emoestudio/EmoeKiLib/README.md

# Emoe KiCad Library

本仓库存储了Emoe R&D的KiCad元件库

# Configure

首先，把这个repo clone到你的电脑上，存放在一个安全的路径\:)  
然后在KiCad的 **设置-配置路径** 中添加以下4条(或者更多)  

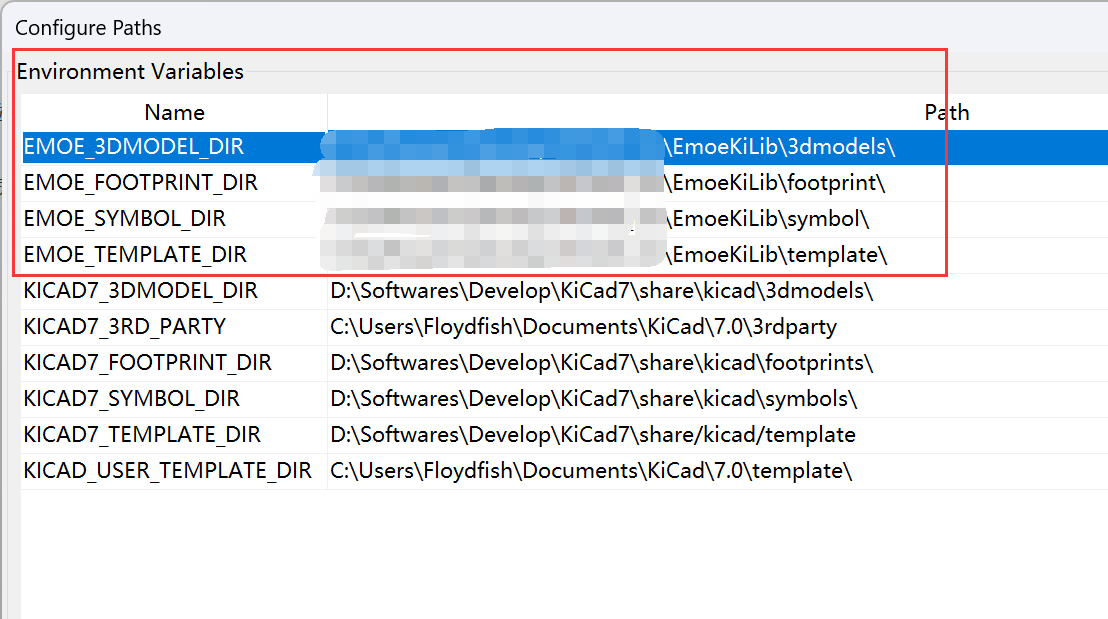
[picture p1: readme_resource/1.png]


这些相当于系统环境变量，他们的作用是在迁移库时使用相对路径，不会发生路径错误问题。  
此时再手动导入你所需要的库，即可使用本库
