emoestudio/EmoeKiLib/3dmodels/Buttons/6.5x6.5x2.55mm_SMD.stp

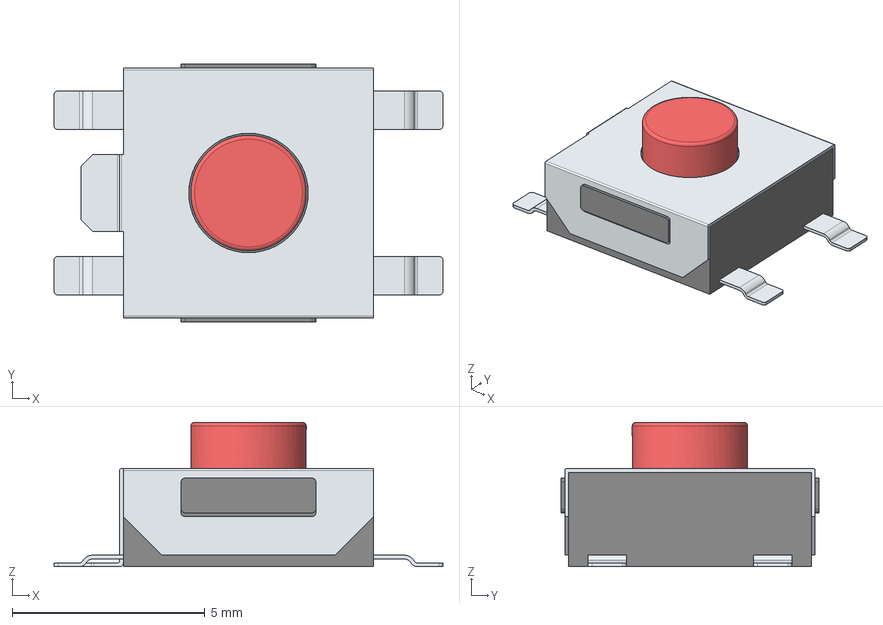
[picture p2: CAD file, 2024-07-07]
3dmodels/Buttons/6.5x6.5x2.55mm_SMD.stp
10.1 x 6.70 x 3.75 mm
Parte_metal
Parte_buton
Parte_mecanism
Parte_pin x 4
