emoestudio/EmoeKiLib/3dmodels/Capacitors/NFM21PC225B0J3D.step

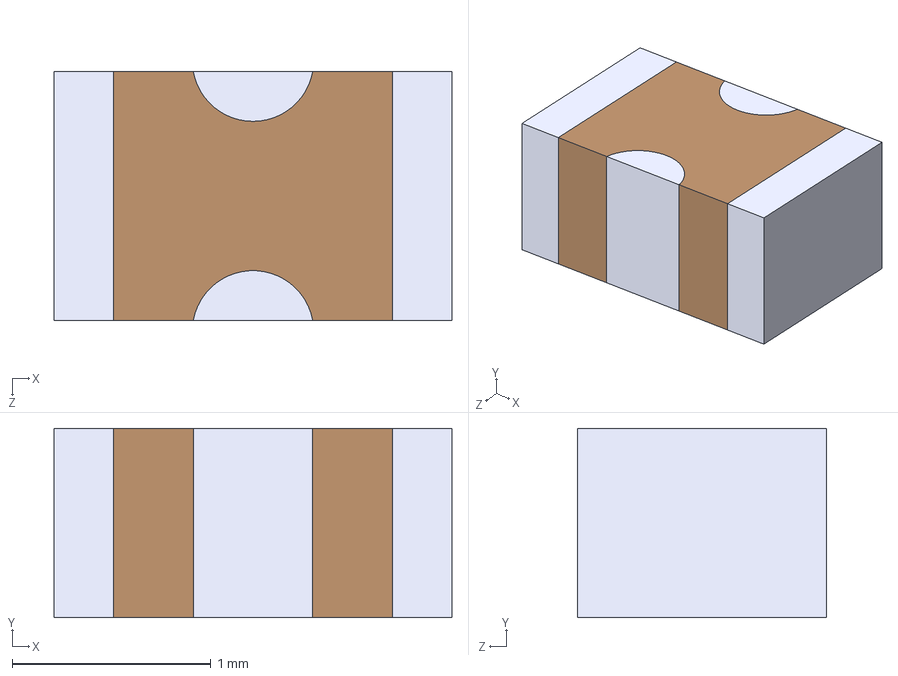
[picture p3: CAD file, 2023-12-09]
3dmodels/Capacitors/NFM21PC225B0J3D.step
2.00 x 0.95 x 1.25 mm
