emoestudio/EmoeKiLib/3dmodels/Connectors/JST_VH3.96/JST - VH - Thru (V) - 4Pin - 3.96mm.stp

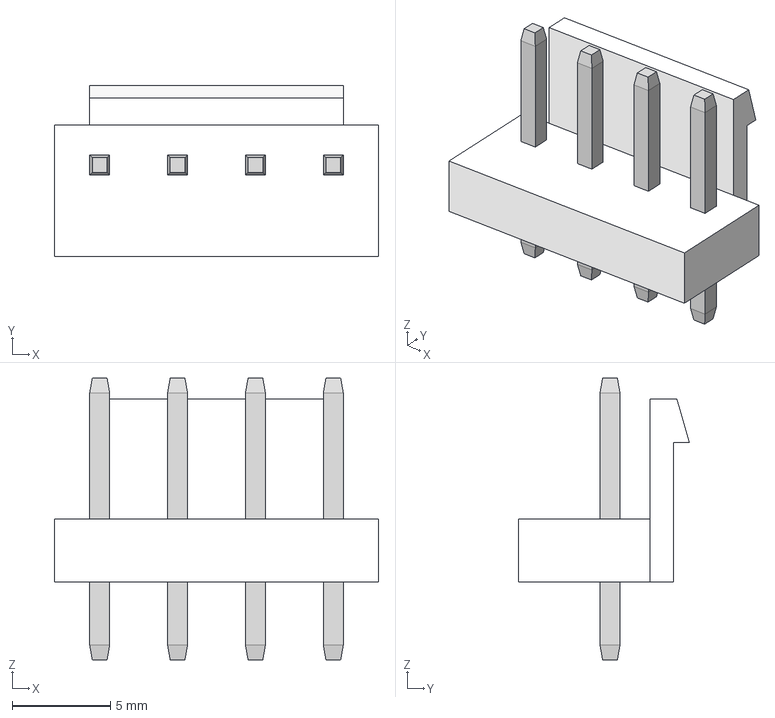
[picture p4: CAD file, 2026-07-21]
3dmodels/Connectors/JST_VH3.96/JST - VH - Thru (V) - 4Pin - 3.96mm.stp
16.5 x 8.69 x 14.3 mm
