emoestudio/EmoeKiLib/3dmodels/Connectors/USB-A-SMD_AF-10.0-QT-ZB6.step

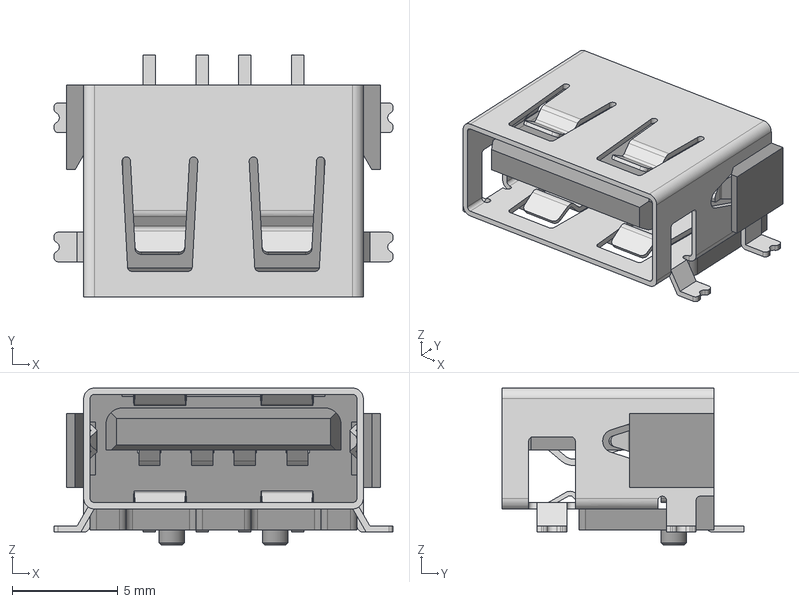
[picture p5: CAD file, 2026-07-21]
3dmodels/Connectors/USB-A-SMD_AF-10.0-QT-ZB6.step
16.0 x 11.4 x 7.40 mm
USB-A-SMD_AF-10.0-QT-ZB6.8~USB-A-SMD_AF-10.0-QT-ZB6.8~VmLX
USB-A-SMD_AF-10.0-QT-ZB6.8~USB-A-SMD_AF-10.0-QT-ZB6.8~VmLX001
USB-A-SMD_AF-10.0-QT-ZB6.8~USB-A-SMD_AF-10.0-QT-ZB6.8~VmLX002
USB-A-SMD_AF-10.0-QT-ZB6.8~USB-A-SMD_AF-10.0-QT-ZB6.8~VmLX003
USB-A-SMD_AF-10.0-QT-ZB6.8~USB-A-SMD_AF-10.0-QT-ZB6.8~VmLX004
USB-A-SMD_AF-10.0-QT-ZB6.8~USB-A-SMD_AF-10.0-QT-ZB6.8~VmLX005
USB-A-SMD_AF-10.0-QT-ZB6.8~USB-A-SMD_AF-10.0-QT-ZB6.8~VmLX006
USB-A-SMD_AF-10.0-QT-ZB6.8~USB-A-SMD_AF-10.0-QT-ZB6.8~VmLX007
USB-A-SMD_AF-10.0-QT-ZB6.8~USB-A-SMD_AF-10.0-QT-ZB6.8~VmLX008
