emoestudio/EmoeKiLib/3dmodels/Crystals/3225_4P_Crystal.STEP

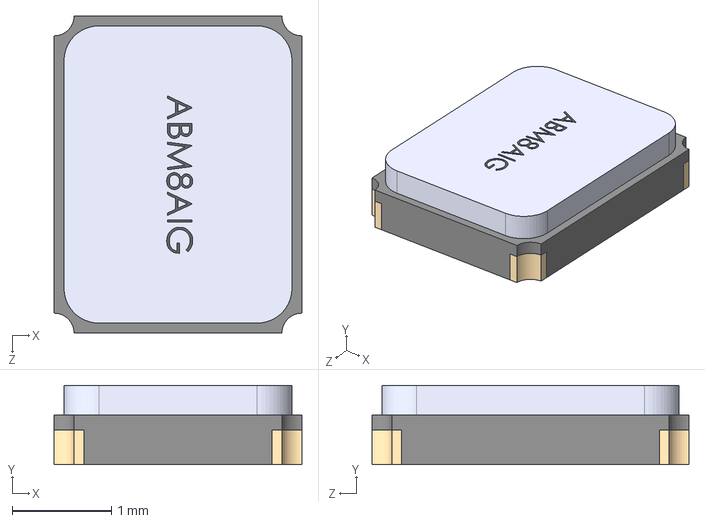
[picture p6: CAD file, 2024-12-31]
3dmodels/Crystals/3225_4P_Crystal.STEP
2.50 x 0.801 x 3.20 mm
