emoestudio/EmoeKiLib/3dmodels/Diodes/TEMD5080X01.stp

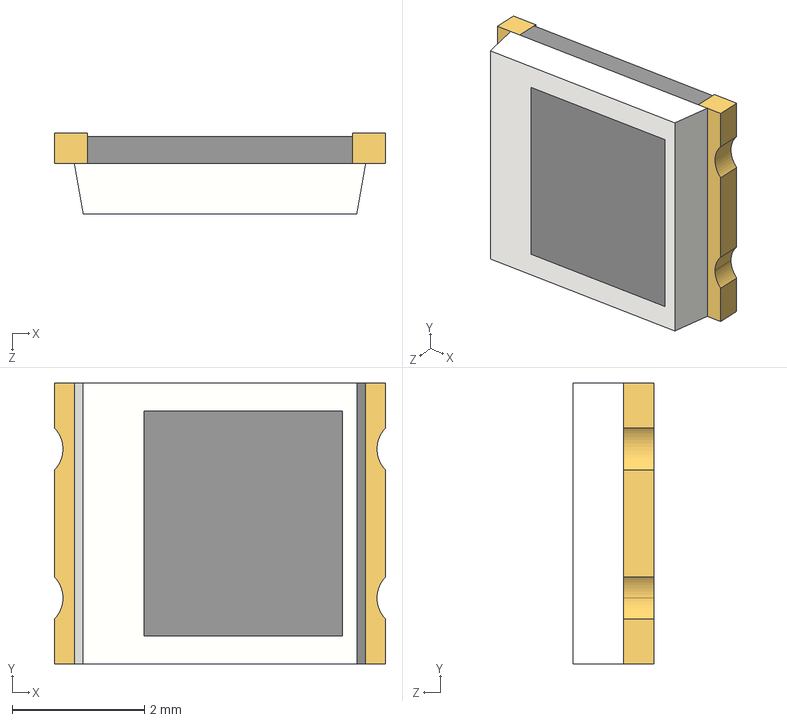
[picture p7: CAD file, 2025-06-23]
3dmodels/Diodes/TEMD5080X01.stp
5.00 x 4.24 x 1.22 mm
