emoestudio/EmoeKiLib/3dmodels/Displays/3mm双孔灯座_上翠绿下红.step

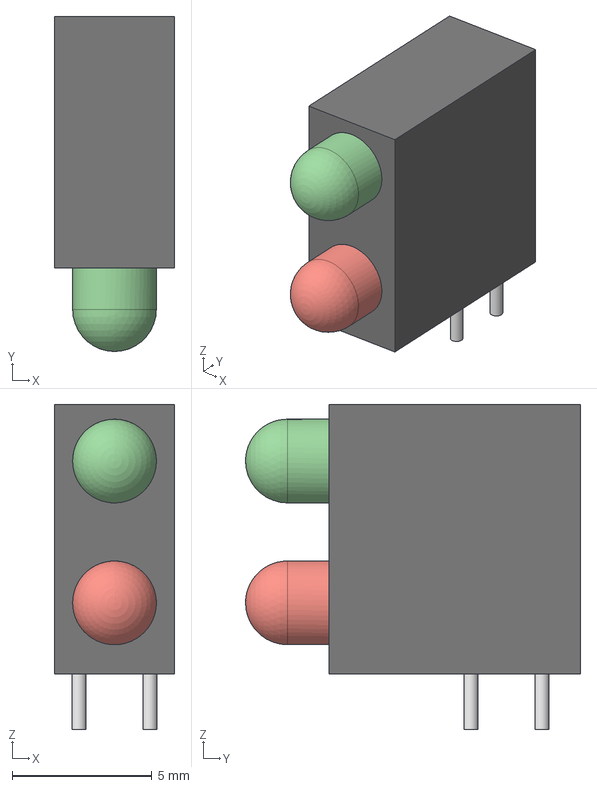
[picture p8: CAD file, 2025-05-03]
3dmodels/Displays/3mm双孔灯座_上翠绿下红.step
4.30 x 12.0 x 11.7 mm
塑料壳
零部件2
零部件3
零部件4
零部件5
零部件6
零部件7
