emoestudio/EmoeKiLib/3dmodels/Inductors/1206_Common_Mode_Choke.STEP

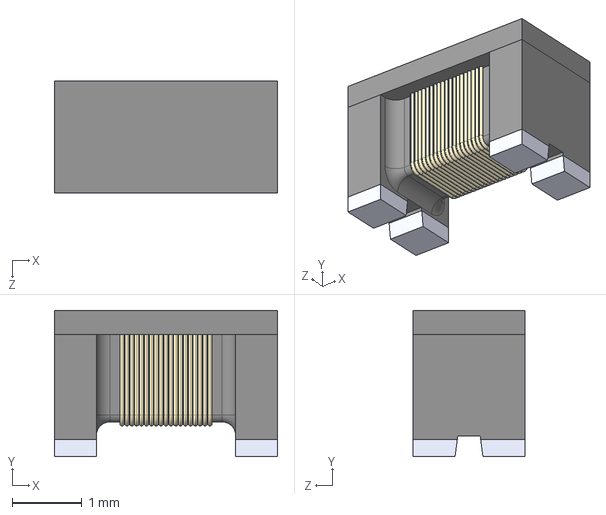
[picture p9: CAD file, 2024-12-31]
3dmodels/Inductors/1206_Common_Mode_Choke.STEP
3.20 x 2.10 x 1.60 mm
