emoestudio/EmoeKiLib/3dmodels/Mechanical/590--3DModel-STEP-630548.STEP

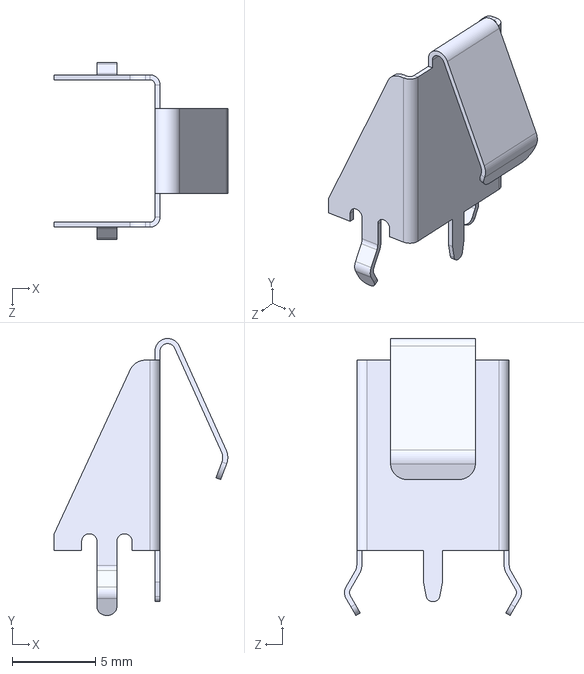
[picture p10: CAD file, 2026-07-21]
3dmodels/Mechanical/590--3DModel-STEP-630548.STEP
10.4 x 16.6 x 10.6 mm
