emoestudio/EmoeKiLib/3dmodels/Package_BGA/LTM8054EY#PBF.stp

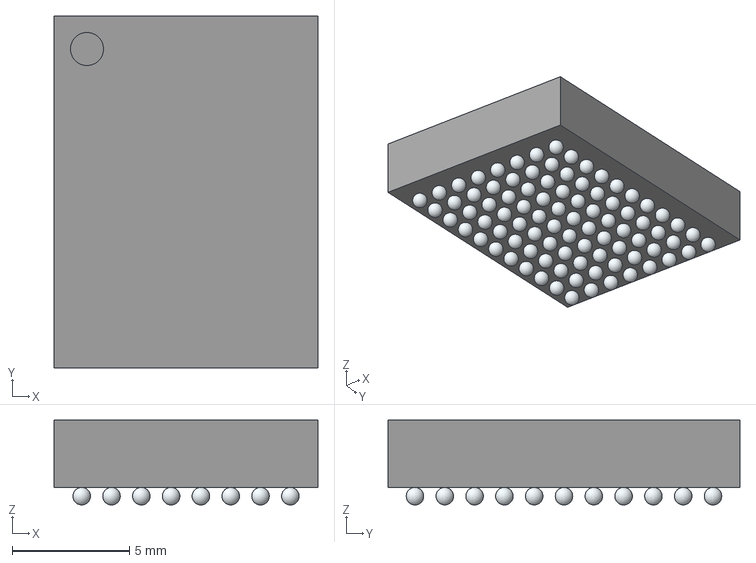
[picture p11: CAD file, 2023-12-09]
3dmodels/Package_BGA/LTM8054EY#PBF.stp
11.2 x 15.0 x 3.62 mm
