emoestudio/EmoeKiLib/3dmodels/Package_LCC/ADR1399KEZ.stp

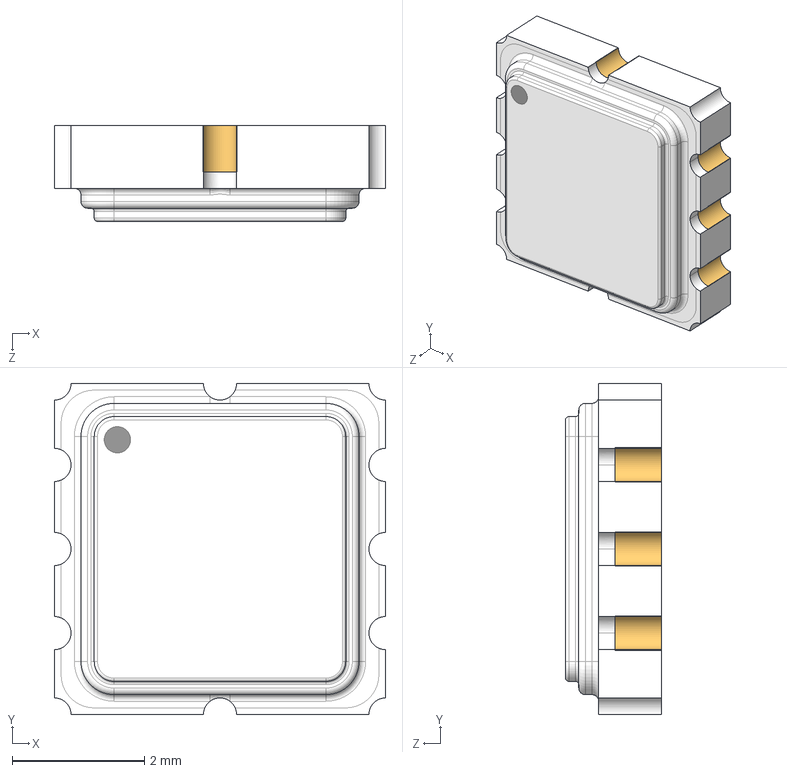
[picture p12: CAD file, 2025-05-23]
3dmodels/Package_LCC/ADR1399KEZ.stp
5.00 x 5.00 x 1.45 mm
