emoestudio/EmoeKiLib/3dmodels/Package_SON/VSON-14-DSJ0014A.stp

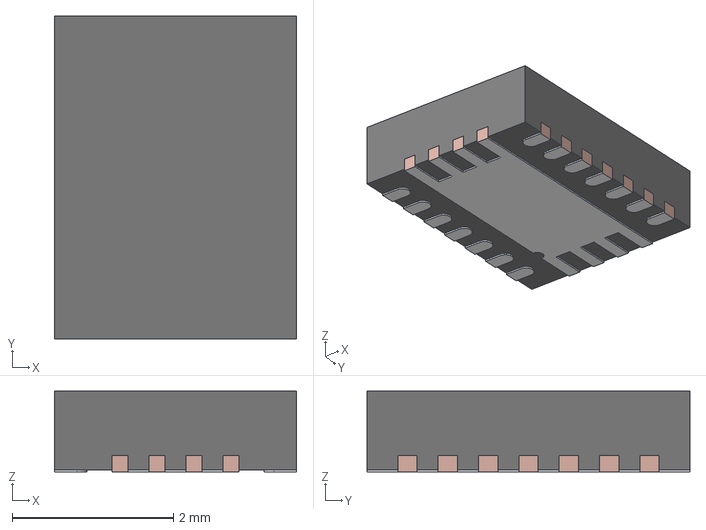
[picture p13: CAD file, 2024-07-07]
3dmodels/Package_SON/VSON-14-DSJ0014A.stp
3.00 x 4.00 x 1.00 mm
FRAME
MOLD
