emoestudio/EmoeKiLib/3dmodels/Package_TO/PA88.stp

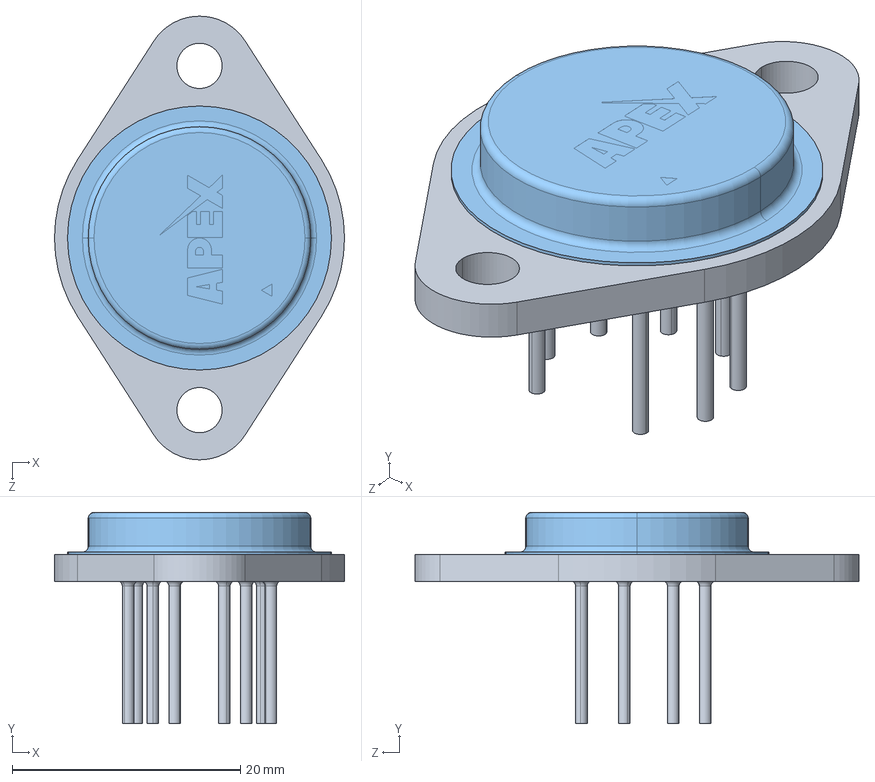
[picture p14: CAD file, 2026-07-21]
3dmodels/Package_TO/PA88.stp
25.4 x 18.5 x 38.9 mm
PHM06M
PSB01
PCM07
