emoestudio/EmoeKiLib/3dmodels/Resistors/VHP203-MetalFoil.step

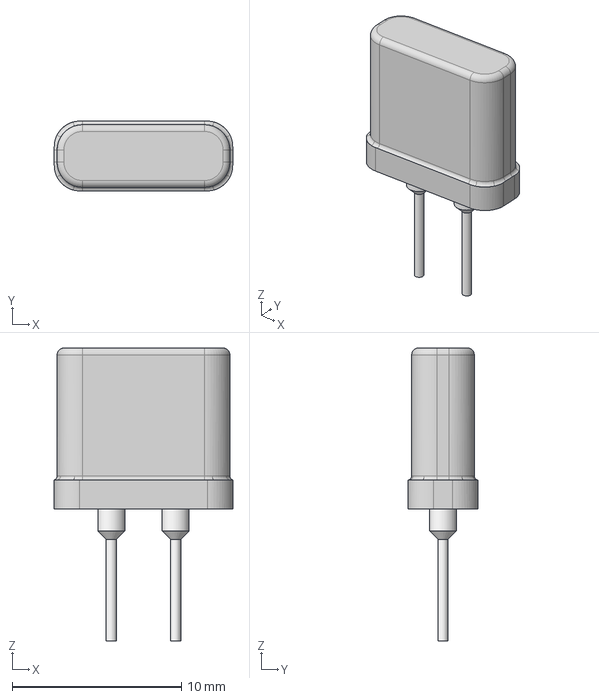
[picture p15: CAD file, 2025-03-30]
3dmodels/Resistors/VHP203-MetalFoil.step
10.5 x 4.12 x 17.3 mm
