emoestudio/EmoeKiLib/3dmodels/Switch_Encoders/SA-0-102-C04.step

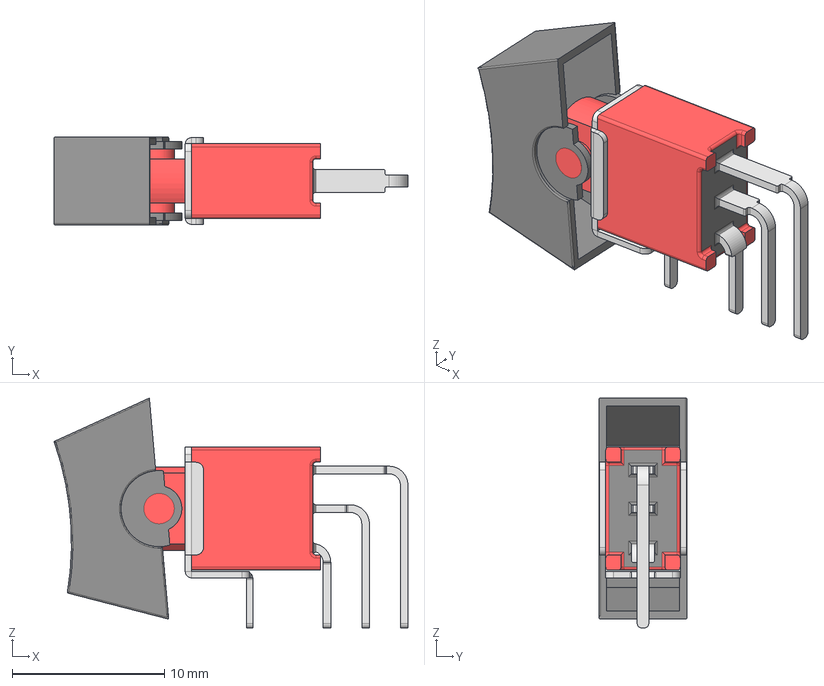
[picture p16: CAD file, 2026-07-21]
3dmodels/Switch_Encoders/SA-0-102-C04.step
23.3 x 5.80 x 15.1 mm
