emoestudio/EmoeKiLib/3dmodels/Connectors/FPC-SMD_20P-P0.50_XUNPU_FPC-05F-20PH20.step

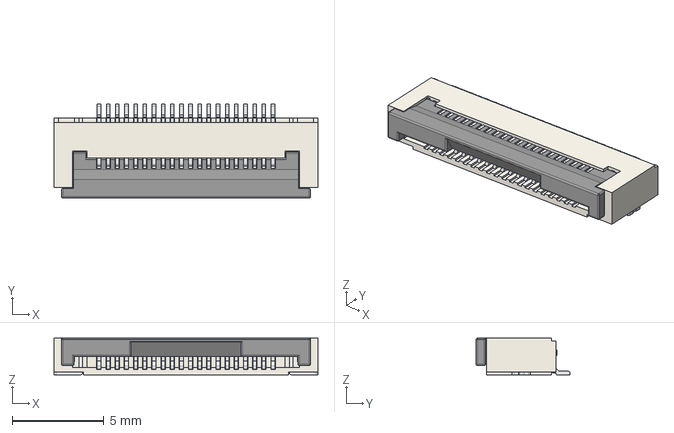
[picture p17: CAD file, 2026-07-21]
3dmodels/Connectors/FPC-SMD_20P-P0.50_XUNPU_FPC-05F-20PH20.step
14.4 x 5.12 x 2.00 mm
