emoestudio/EmoeKiLib/3dmodels/Connectors/JST_VH3.96/JST - VH - Thru (V) - 10Pin - 3.96mm.stp

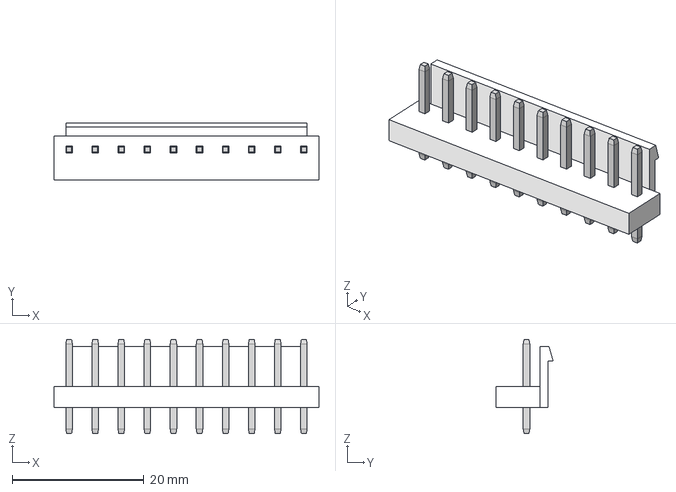
[picture p18: CAD file, 2026-07-21]
3dmodels/Connectors/JST_VH3.96/JST - VH - Thru (V) - 10Pin - 3.96mm.stp
40.2 x 8.69 x 14.3 mm
