emoestudio/EmoeKiLib/3dmodels/Diodes/UMSB30M.stp

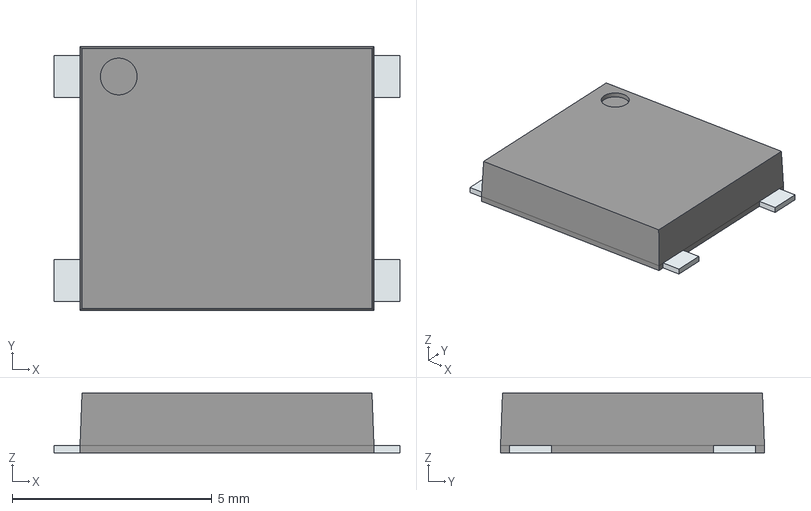
[picture p19: CAD file, 2024-01-21]
3dmodels/Diodes/UMSB30M.stp
8.65 x 6.60 x 1.50 mm
PinsArrayL
PinsArrayR
