emoestudio/EmoeKiLib/3dmodels/Displays/OLED  0.96 inch 64x128.STEP

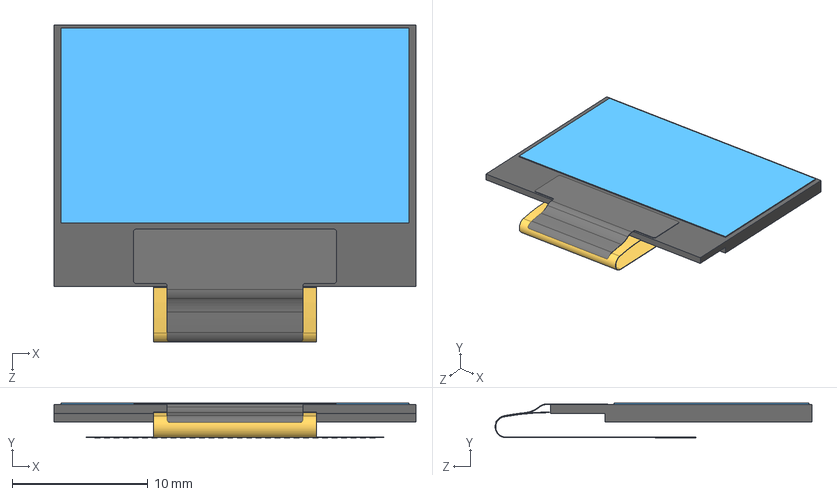
[picture p20: CAD file, 2024-07-07]
3dmodels/Displays/OLED 0.96 inch 64x128.STEP
26.7 x 2.56 x 23.4 mm
