emoestudio/EmoeKiLib/3dmodels/Mechanical/LEP3-4.1.step

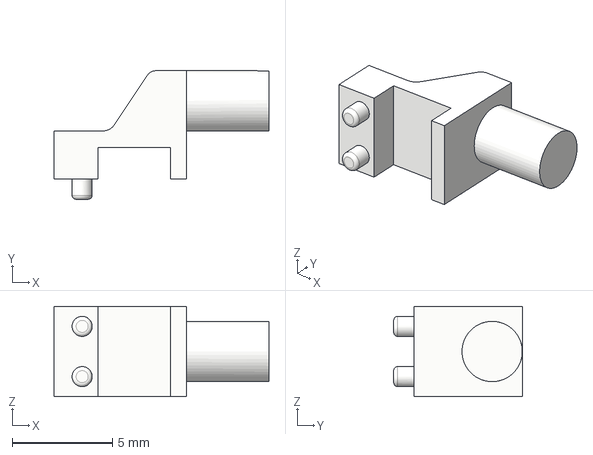
[picture p21: CAD file, 2024-07-07]
3dmodels/Mechanical/LEP3-4.1.step
10.7 x 6.40 x 4.50 mm
