emoestudio/EmoeKiLib/3dmodels/Package_BGA/AD4632-24BBCZ.stp

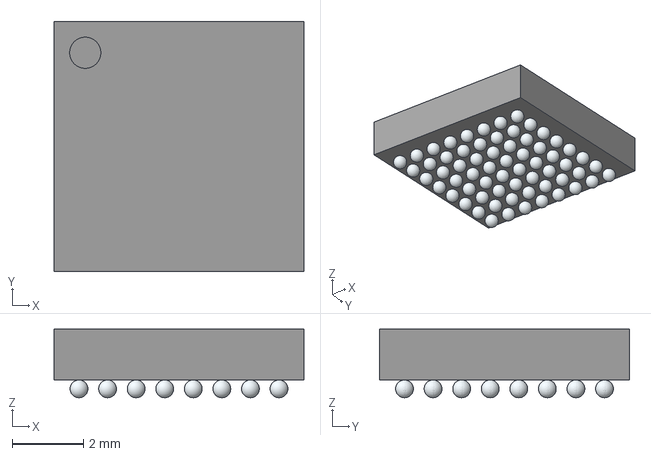
[picture p22: CAD file, 2023-12-09]
3dmodels/Package_BGA/AD4632-24BBCZ.stp
7.00 x 7.00 x 1.92 mm
