emoestudio/EmoeKiLib/3dmodels/Package_LCC/ADR1001AEZ.stp

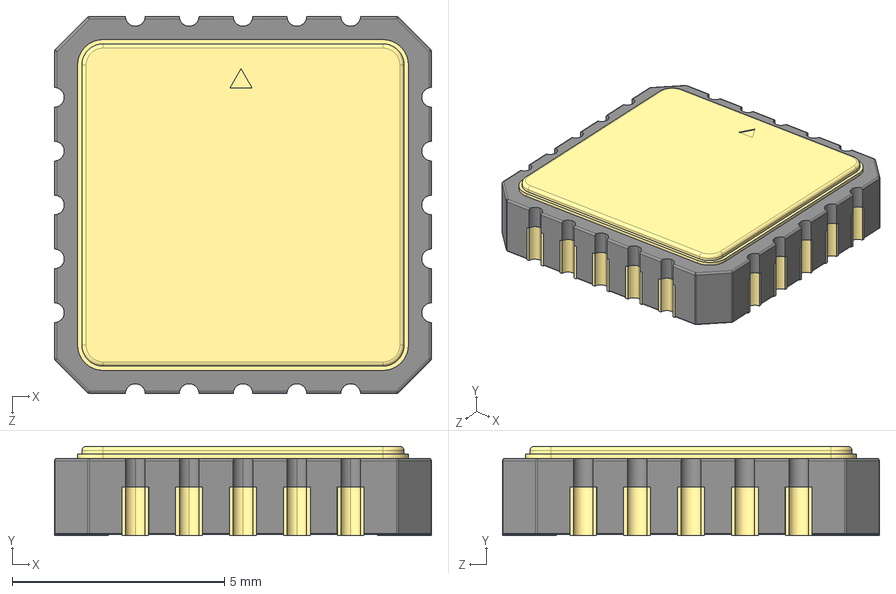
[picture p23: CAD file, 2025-05-03]
3dmodels/Package_LCC/ADR1001AEZ.stp
8.89 x 2.10 x 8.89 mm
