emoestudio/EmoeKiLib/3dmodels/Switch_Encoders/RS1010-CTR.step

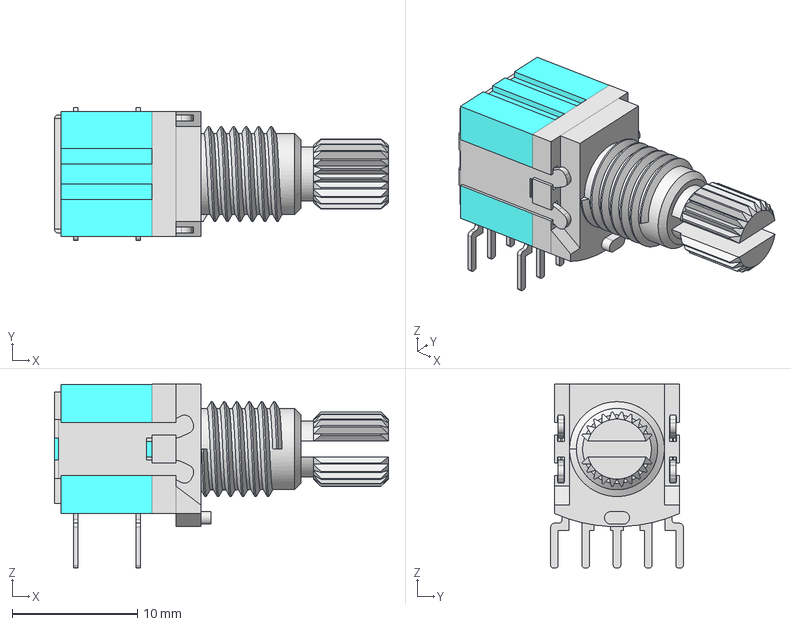
[picture p24: CAD file, 2026-07-21]
3dmodels/Switch_Encoders/RS1010-CTR.step
26.7 x 10.6 x 14.7 mm
