emoestudio/EmoeKiLib/3dmodels/Transformers/VPT87DDF01B.stp

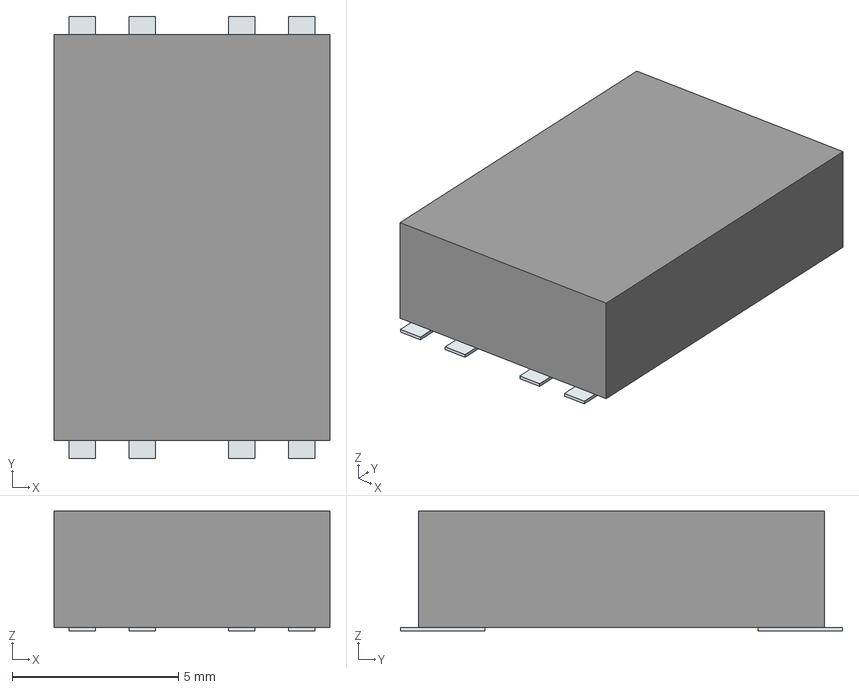
[picture p25: CAD file, 2026-02-11]
3dmodels/Transformers/VPT87DDF01B.stp
8.30 x 13.3 x 3.60 mm
Pins
