emoestudio/EmoeKiLib/3dmodels/Connectors/USB-C-GT-USB-7047A.step

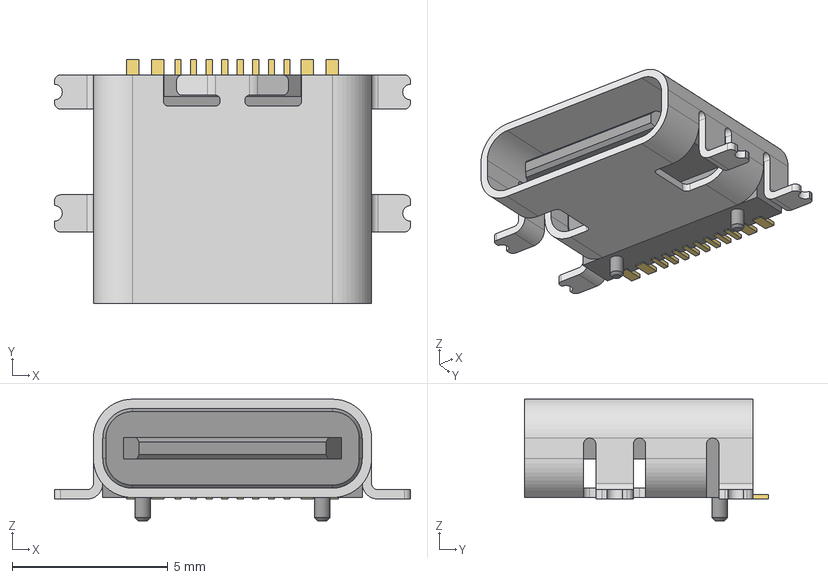
[picture p27: CAD file, 2026-07-21]
3dmodels/Connectors/USB-C-GT-USB-7047A.step
11.4 x 7.85 x 3.91 mm
