emoestudio/EmoeKiLib/3dmodels/Mechanical/5015.stp

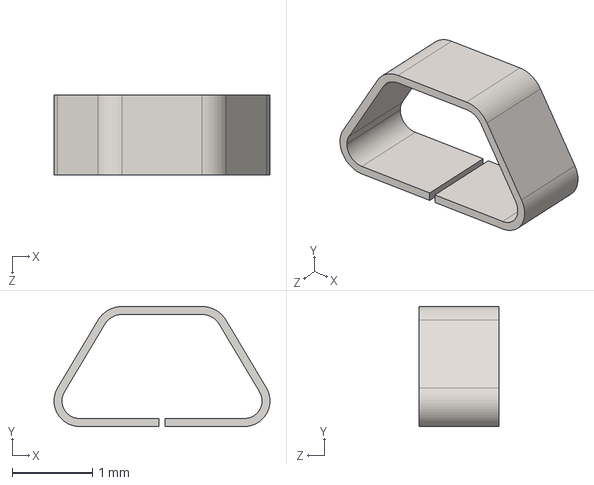
[picture p28: CAD file, 2024-07-07]
3dmodels/Mechanical/5015.stp
2.70 x 1.50 x 1.00 mm
