emoestudio/EmoeKiLib/3dmodels/Transformers/PE4820-I.step

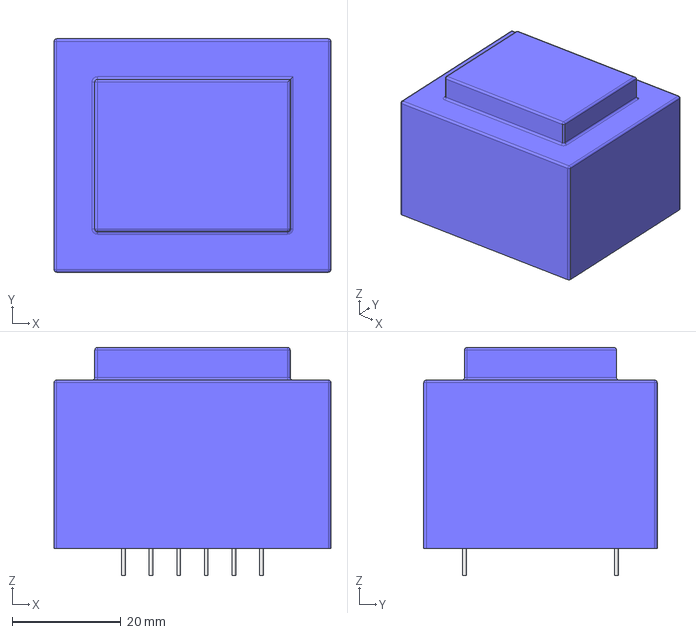
[picture p29: CAD file, 2026-02-11]
3dmodels/Transformers/PE4820-I.step
51.0 x 43.0 x 42.0 mm
