emoestudio/EmoeKiLib/3dmodels/Connectors/SGD-08-2x40P_0.8mm_Male.step

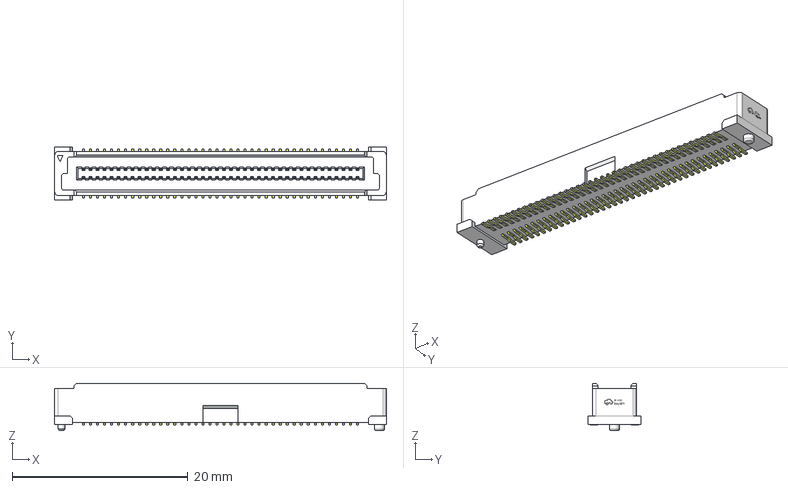
[picture p31: CAD file, 2026-07-21]
3dmodels/Connectors/SGD-08-2x40P_0.8mm_Male.step
37.8 x 6.00 x 5.40 mm
