emoestudio/EmoeKiLib/3dmodels/Switch_Encoders/MR-0-102-A01.step

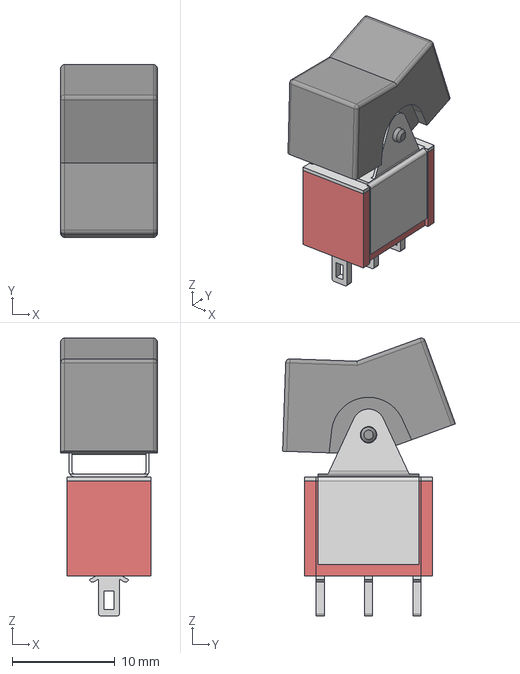
[picture p32: CAD file, 2026-07-21]
3dmodels/Switch_Encoders/MR-0-102-A01.step
9.40 x 16.8 x 27.0 mm
