emoestudio/EmoeKiLib/3dmodels/Transformers/VPT85BB-01A.stp

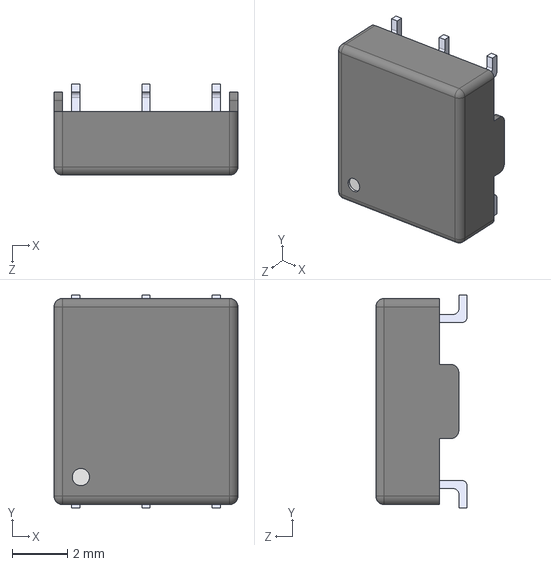
[picture p33: CAD file, 2026-02-11]
3dmodels/Transformers/VPT85BB-01A.stp
6.65 x 7.70 x 3.30 mm
