emoestudio/EmoeKiLib/3dmodels/Connectors/HC-1.25-3PWT.step

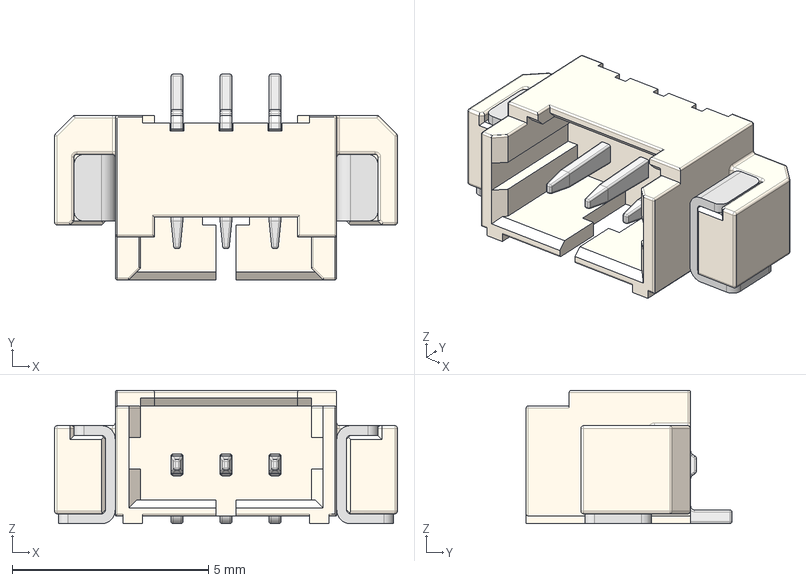
[picture p34: CAD file, 2026-07-21]
3dmodels/Connectors/HC-1.25-3PWT.step
8.75 x 5.25 x 3.40 mm
CONN-SMD_HC-1.25-3PWT~CONN-SMD_HC-1.25-3PWT~GvZF
CONN-SMD_HC-1.25-3PWT~CONN-SMD_HC-1.25-3PWT~GvZF001
CONN-SMD_HC-1.25-3PWT~CONN-SMD_HC-1.25-3PWT~GvZF002
