emoestudio/EmoeKiLib/3dmodels/Switch_Encoders/6x6mm_17mm_Button_THT.stp

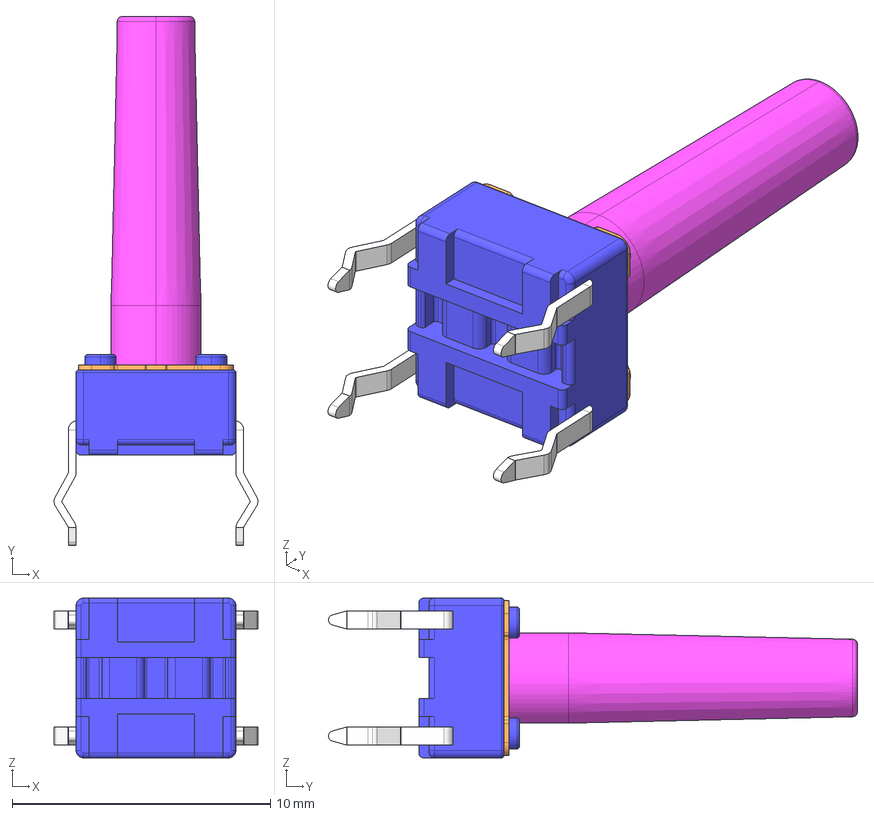
[picture p36: CAD file, 2026-07-21]
3dmodels/Switch_Encoders/6x6mm_17mm_Button_THT.stp
7.90 x 20.5 x 6.20 mm
