emoestudio/EmoeKiLib/3dmodels/Connectors/SGD-08-2x40P_0.8mm_Female.step

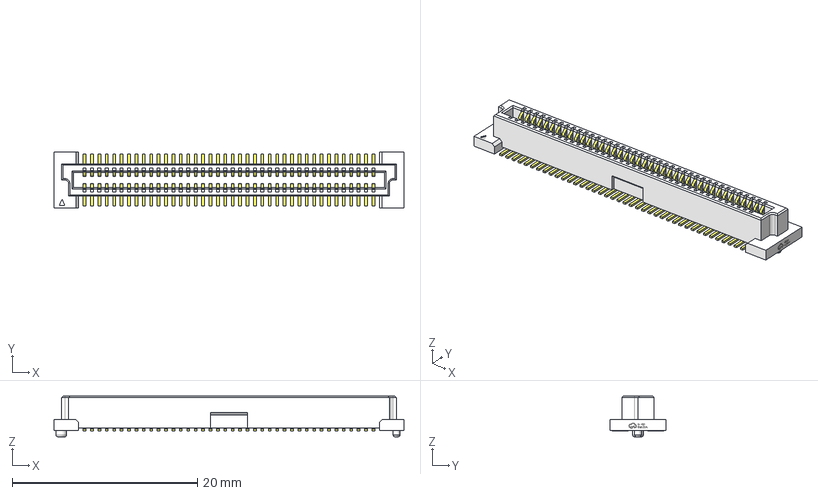
[picture p38: CAD file, 2026-07-21]
3dmodels/Connectors/SGD-08-2x40P_0.8mm_Female.step
37.8 x 6.00 x 4.40 mm
