emoestudio/EmoeKiLib/3dmodels/Switch_Encoders/PER-08H.step

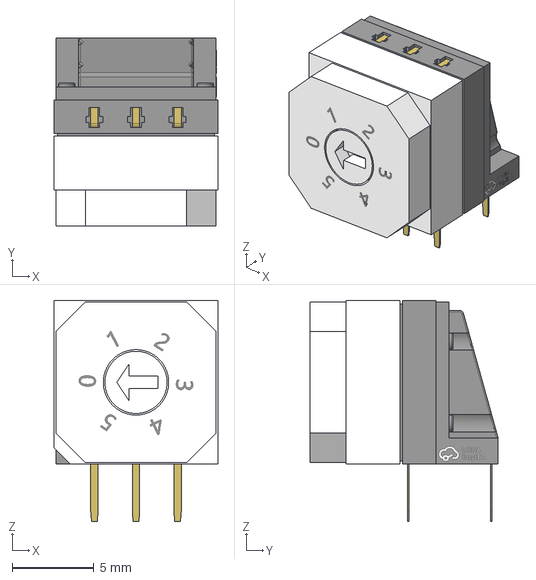
[picture p39: CAD file, 2026-02-11]
3dmodels/Switch_Encoders/PER-08H.step
10.00 x 11.5 x 13.5 mm
