emoestudio/EmoeKiLib/3dmodels/Connectors/ZH1.5-2PWT.step

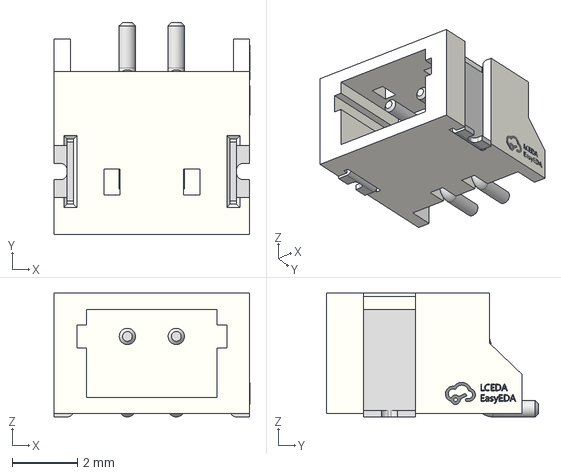
[picture p41: CAD file, 2026-02-11]
3dmodels/Connectors/ZH1.5-2PWT.step
6.01 x 6.50 x 3.80 mm
