emoestudio/EmoeKiLib/3dmodels/Switch_Encoders/MTS-1xx-A4-blue.step

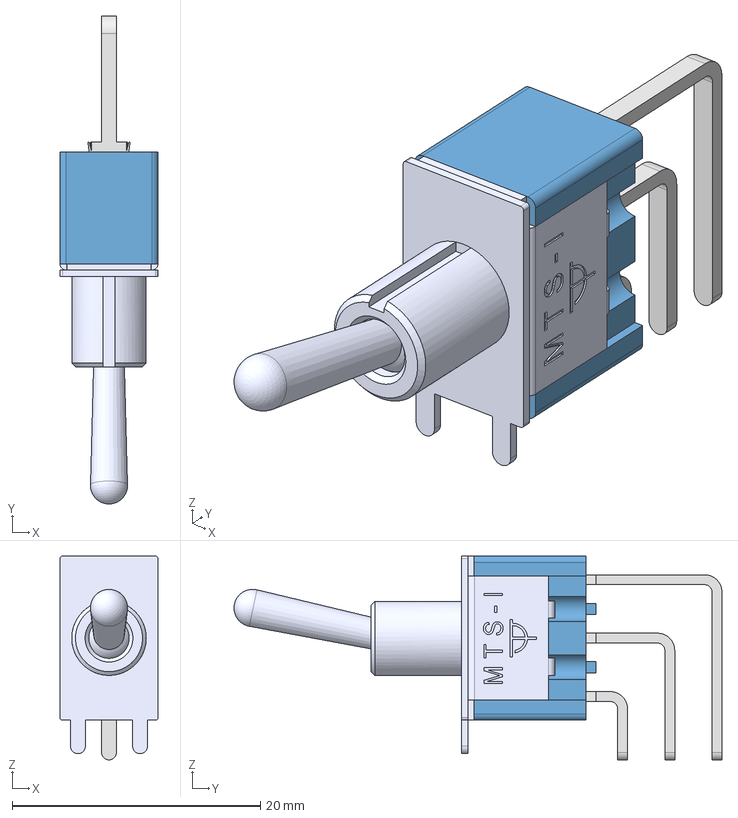
[picture p42: CAD file, 2025-12-01]
3dmodels/Switch_Encoders/MTS-1xx-A4-blue.step
7.90 x 39.3 x 16.4 mm
Handle
L
Housing
