emoestudio/EmoeKiLib/3dmodels/Connectors/XH2.54-10-PWT.step

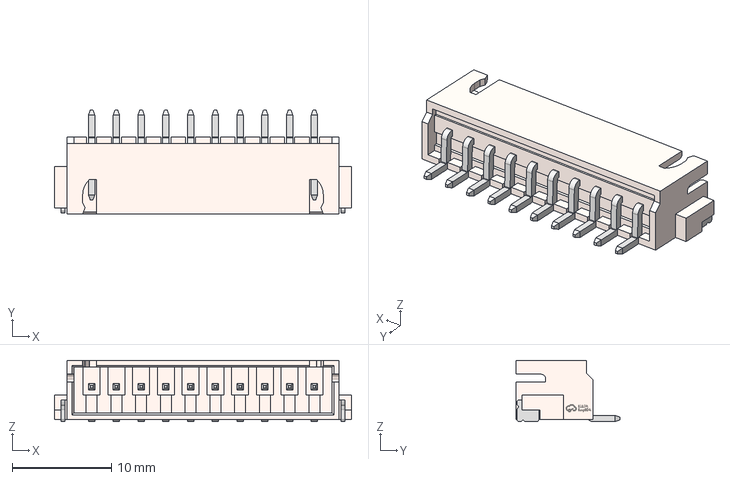
[picture p44: CAD file, 2026-02-11]
3dmodels/Connectors/XH2.54-10-PWT.step
30.0 x 10.5 x 6.20 mm
