emoestudio/EmoeKiLib/3dmodels/Switch_Encoders/SRBM120700.stp

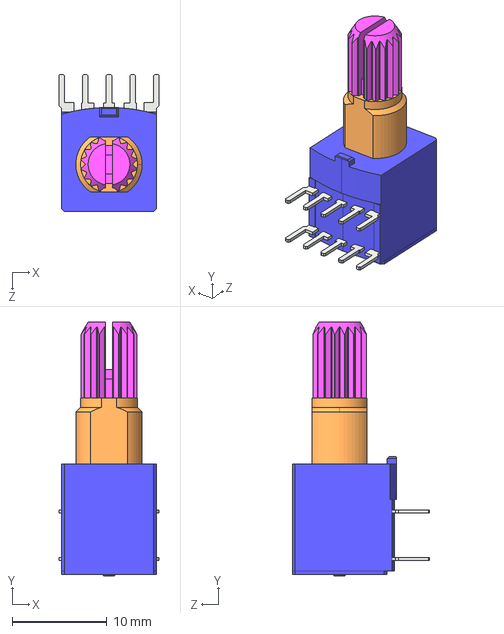
[picture p45: CAD file, 2025-03-30]
3dmodels/Switch_Encoders/SRBM120700.stp
10.6 x 26.8 x 14.5 mm
