emoestudio/EmoeKiLib/3dmodels/Connectors/XH2.54-8-PLT.step

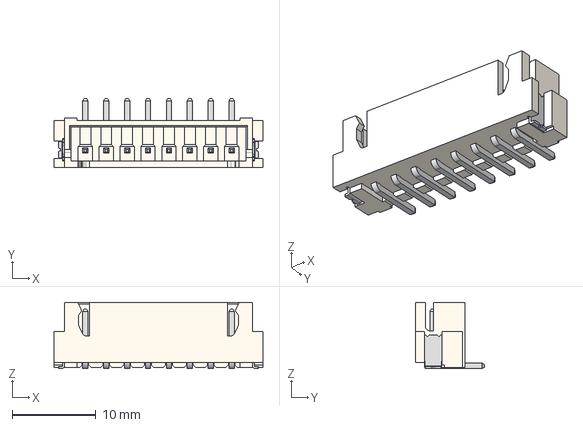
[picture p47: CAD file, 2026-02-11]
3dmodels/Connectors/XH2.54-8-PLT.step
25.0 x 8.30 x 7.90 mm
