emoestudio/EmoeKiLib/3dmodels/Switch_Encoders/Tactal Switch - SMD (12mmx12mmx7.5mm).stp

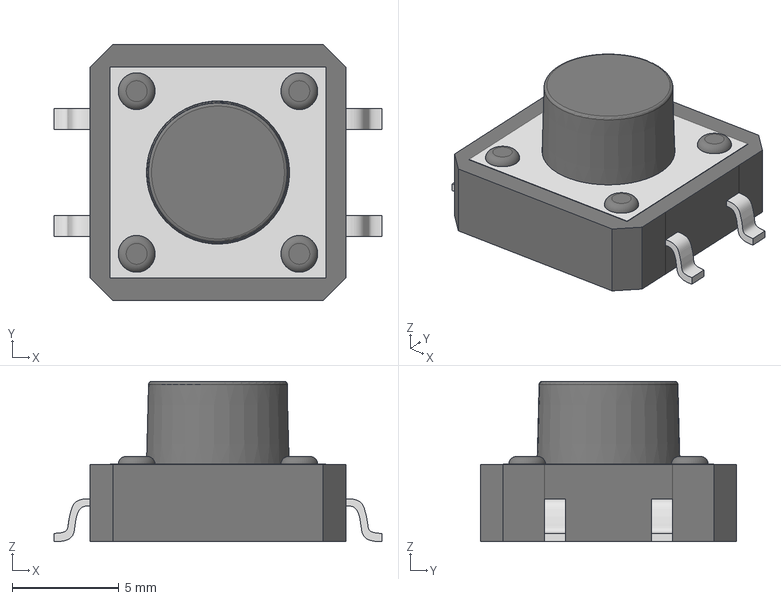
[picture p48: CAD file, 2025-03-30]
3dmodels/Switch_Encoders/Tactal Switch - SMD (12mmx12mmx7.5mm).stp
15.4 x 12.0 x 7.50 mm
