emoestudio/EmoeKiLib/3dmodels/Connectors/USB Type-B Stand.step

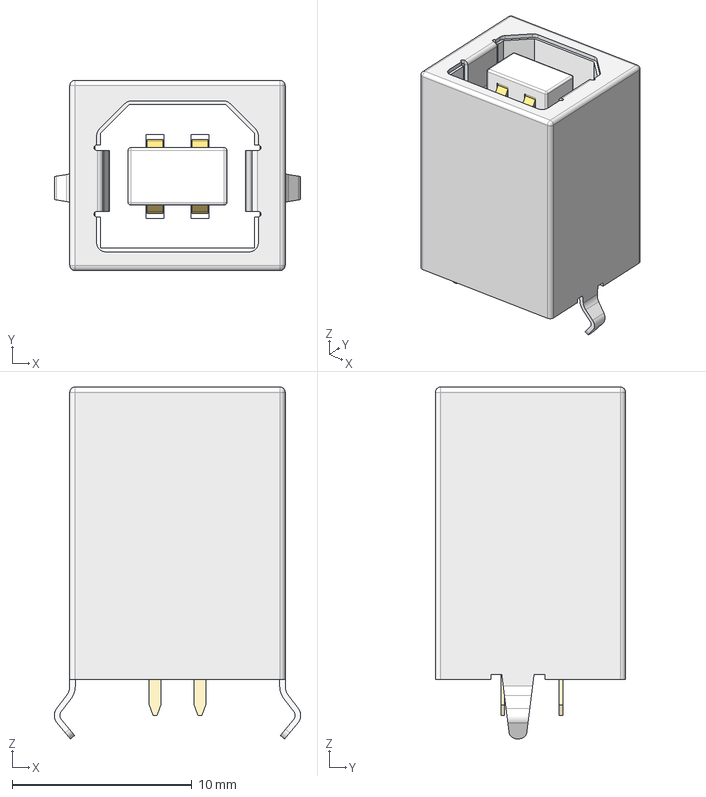
[picture p50: CAD file, 2026-02-11]
3dmodels/Connectors/USB Type-B Stand.step
13.7 x 10.6 x 19.6 mm
