emoestudio/EmoeKiLib/3dmodels/Switch_Encoders/SS-12D11.STEP

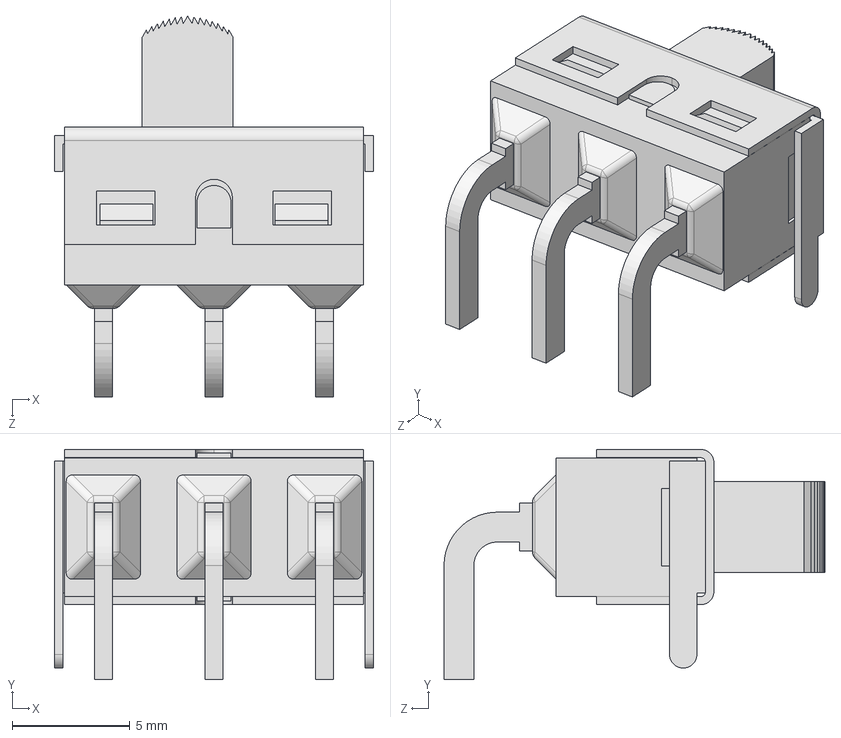
[picture p51: CAD file, 2023-12-10]
3dmodels/Switch_Encoders/SS-12D11.STEP
13.6 x 9.78 x 16.2 mm
