emoestudio/EmoeKiLib/3dmodels/Connectors/SMA-KWE-20mm.step

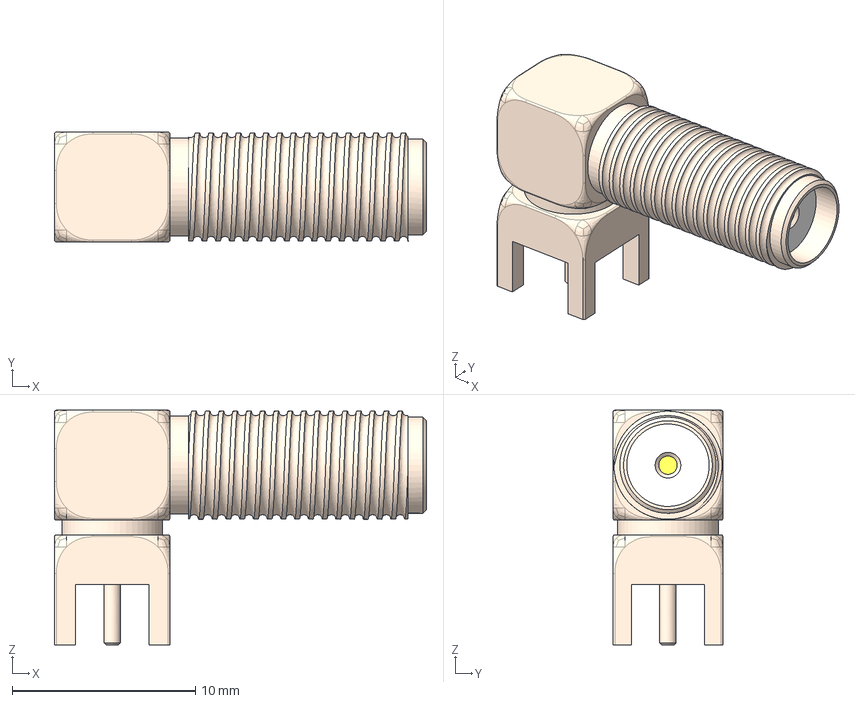
[picture p53: CAD file, 2026-02-11]
3dmodels/Connectors/SMA-KWE-20mm.step
20.3 x 6.00 x 12.8 mm
