emoestudio/EmoeKiLib/3dmodels/Switch_Encoders/MTS-1xx-C3-blue.step

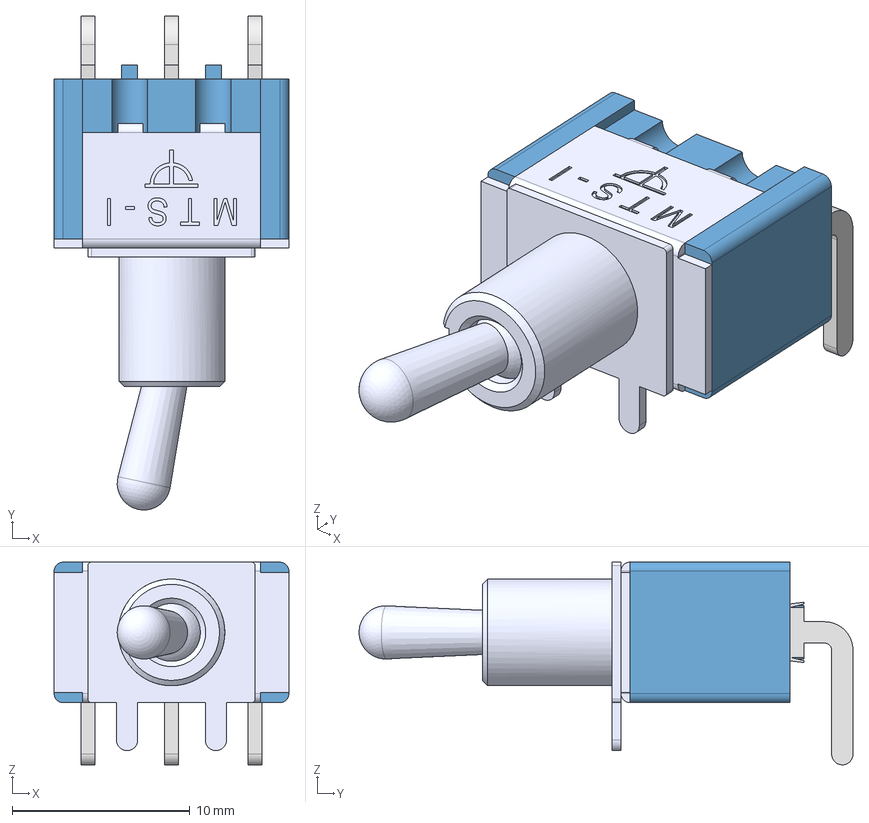
[picture p54: CAD file, 2023-12-10]
3dmodels/Switch_Encoders/MTS-1xx-C3-blue.step
13.2 x 27.8 x 11.4 mm
Handle
L
Housing
