emoestudio/EmoeKiLib/3dmodels/Connectors/BNC-KWE-90degrees-15mm.STEP

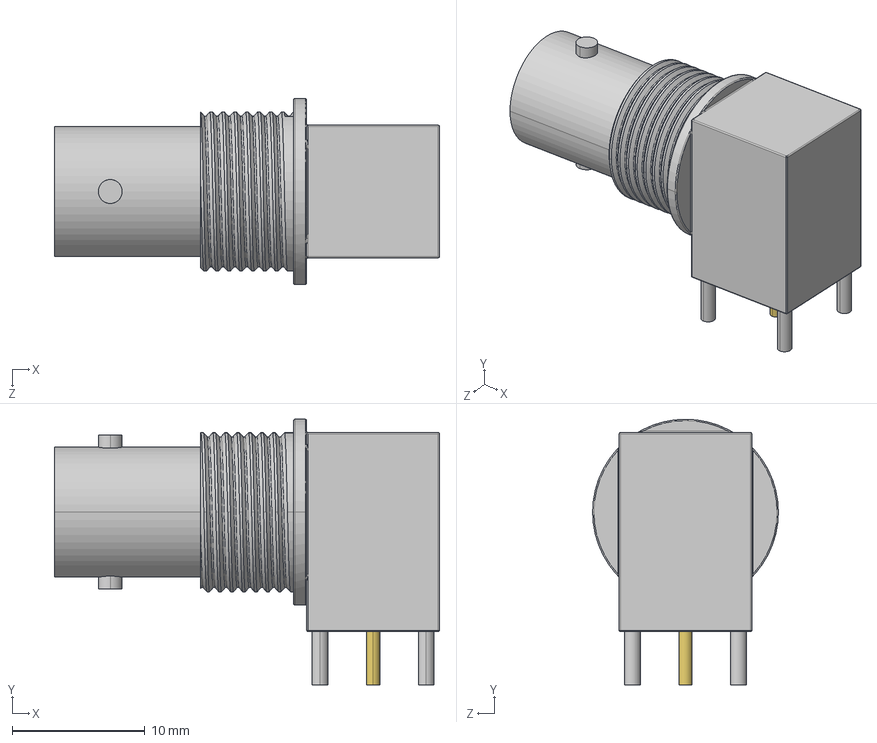
[picture p55: CAD file, 2026-02-11]
3dmodels/Connectors/BNC-KWE-90degrees-15mm.STEP
29.0 x 20.0 x 14.0 mm
