emoestudio/EmoeKiLib/3dmodels/Connectors/XH2.54-4PLT.step

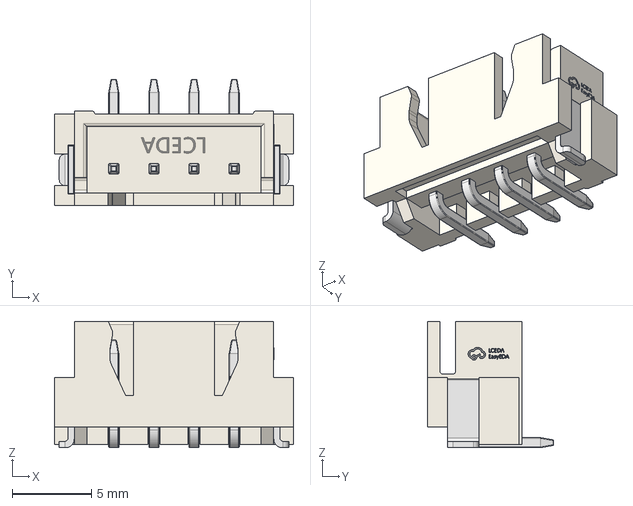
[picture p56: CAD file, 2026-02-11]
3dmodels/Connectors/XH2.54-4PLT.step
15.1 x 8.00 x 8.00 mm
