emoestudio/EmoeKiLib/3dmodels/Connectors/TYPE-C 6P CB1.6.step

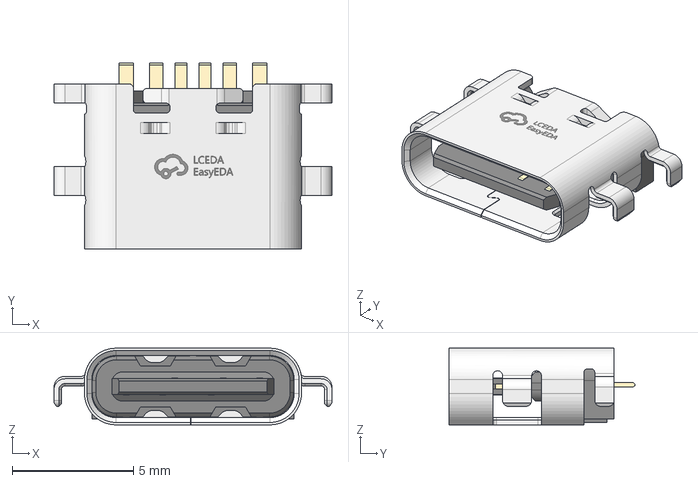
[picture p57: CAD file, 2026-02-11]
3dmodels/Connectors/TYPE-C 6P CB1.6.step
11.4 x 7.65 x 3.16 mm
