emoestudio/EmoeKiLib/3dmodels/Connectors/PH2.0-2PWB.step

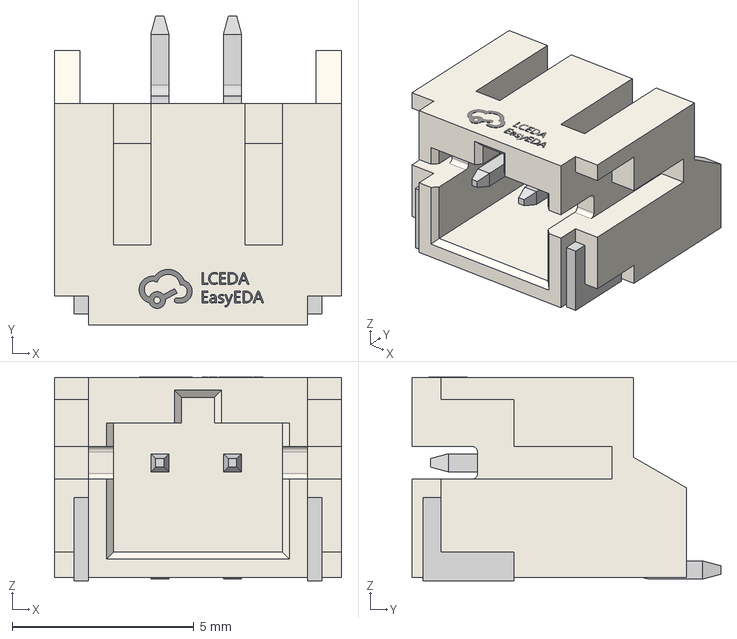
[picture p58: CAD file, 2026-02-11]
3dmodels/Connectors/PH2.0-2PWB.step
7.90 x 8.50 x 5.61 mm
