emoestudio/EmoeKiLib/3dmodels/Connectors/XH2.54-10-PLT.step

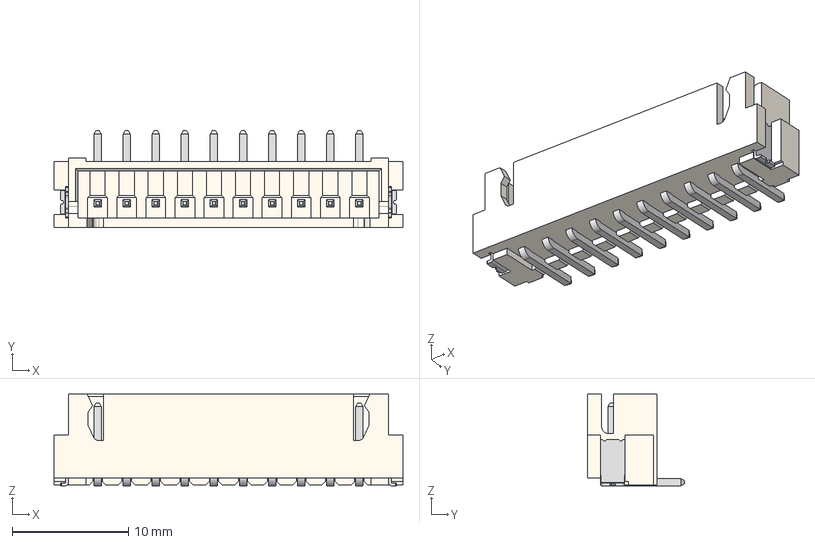
[picture p59: CAD file, 2026-02-11]
3dmodels/Connectors/XH2.54-10-PLT.step
30.0 x 8.30 x 7.90 mm
