emoestudio/EmoeKiLib/3dmodels/Connectors/BNC-KWE-90 degrees.STEP

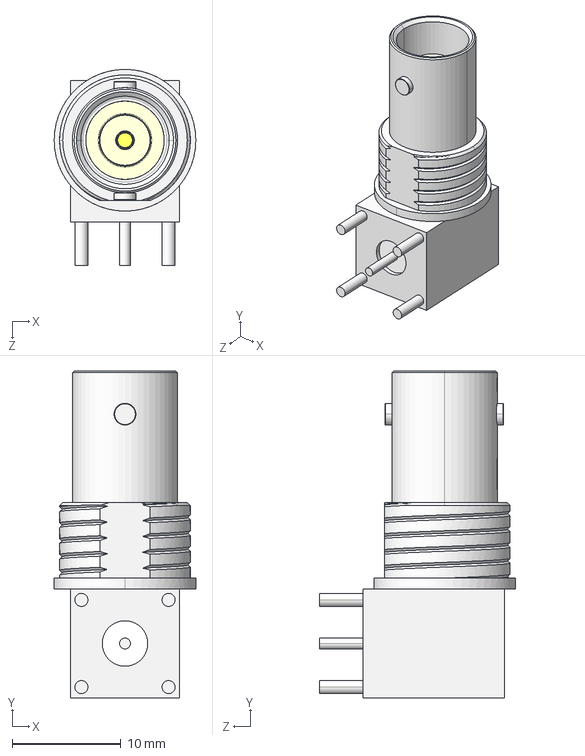
[picture p60: CAD file, 2025-12-01]
3dmodels/Connectors/BNC-KWE-90 degrees.STEP
13.0 x 30.0 x 18.0 mm
