emoestudio/EmoeKiLib/3dmodels/Connectors/USB-B-S-F-W-TH.stp

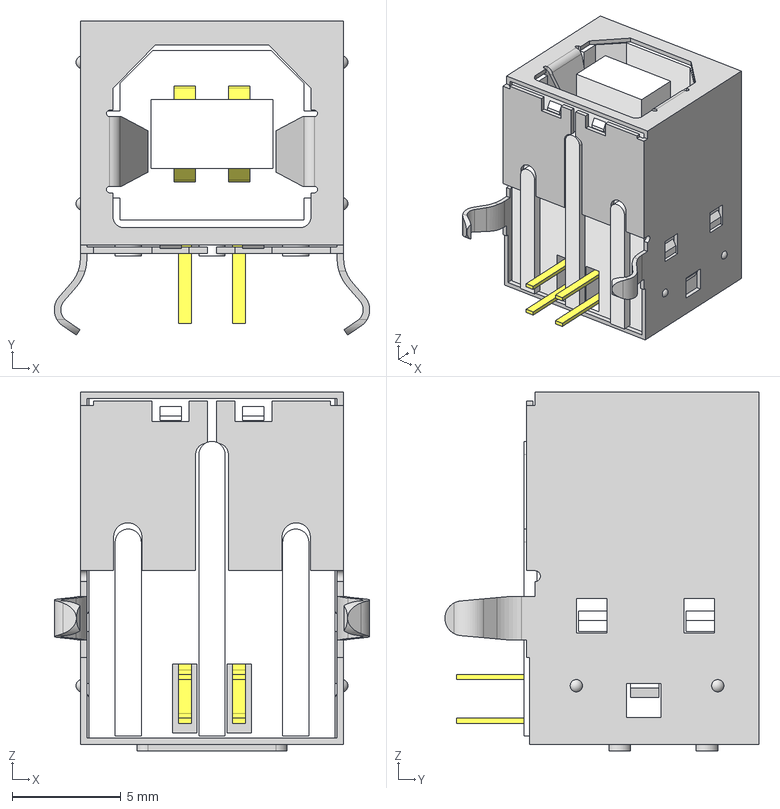
[picture p61: CAD file, 2025-12-01]
3dmodels/Connectors/USB-B-S-F-W-TH.stp
14.5 x 14.4 x 16.5 mm
USB-B-S-TH_S
USB-B-S-W-TH_B
USB-B-S-TH_P
