emoestudio/EmoeKiLib/3dmodels/Connectors/FCR7350-BananaJack.stp

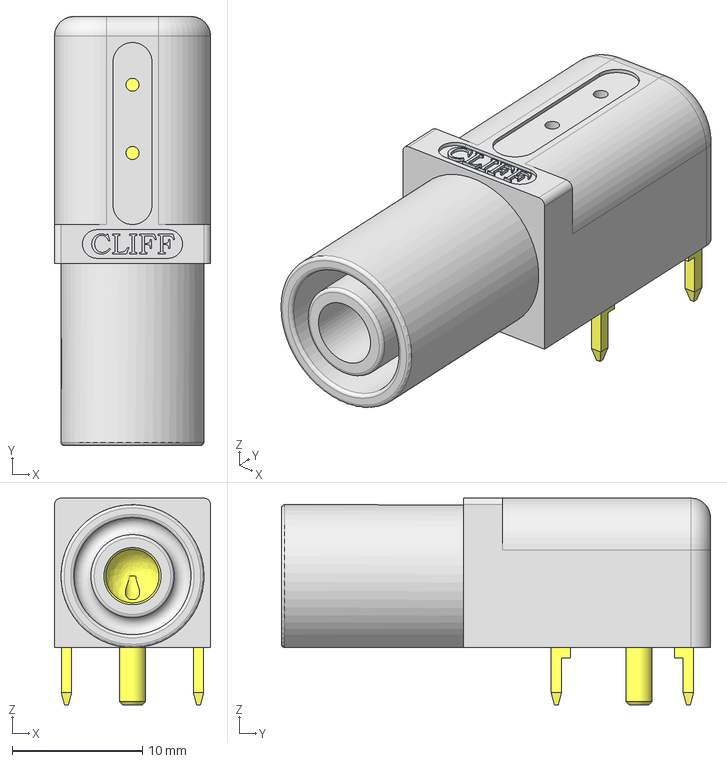
[picture p62: CAD file, 2025-10-14]
3dmodels/Connectors/FCR7350-BananaJack.stp
12.0 x 33.0 x 15.9 mm
