emoestudio/EmoeKiLib/3dmodels/Connectors/Amphernol_SMA_Verticle_901-144-3.stp

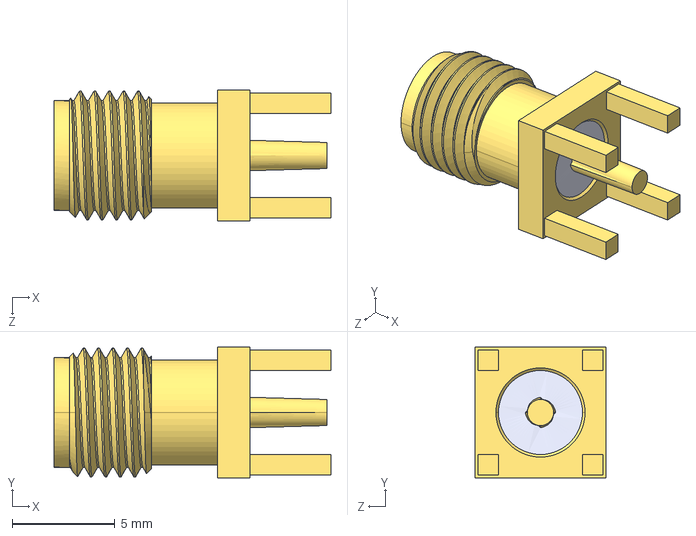
[picture p63: CAD file, 2025-05-03]
3dmodels/Connectors/Amphernol_SMA_Verticle_901-144-3.stp
13.5 x 6.35 x 6.35 mm
