emoestudio/EmoeKiLib/3dmodels/Connectors/BM12B-SRSS-TB.STEP

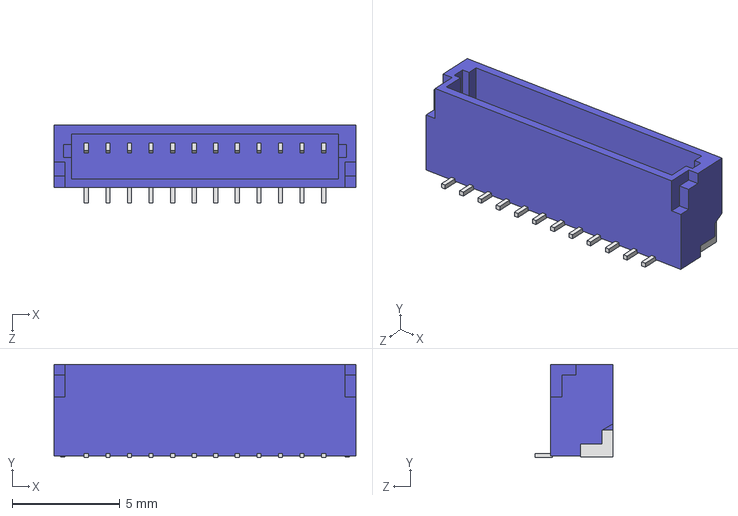
[picture p64: CAD file, 2025-03-13]
3dmodels/Connectors/BM12B-SRSS-TB.STEP
14.0 x 4.32 x 3.60 mm
