emoestudio/EmoeKiLib/3dmodels/Connectors/USB2.0-A-双层直插.stp

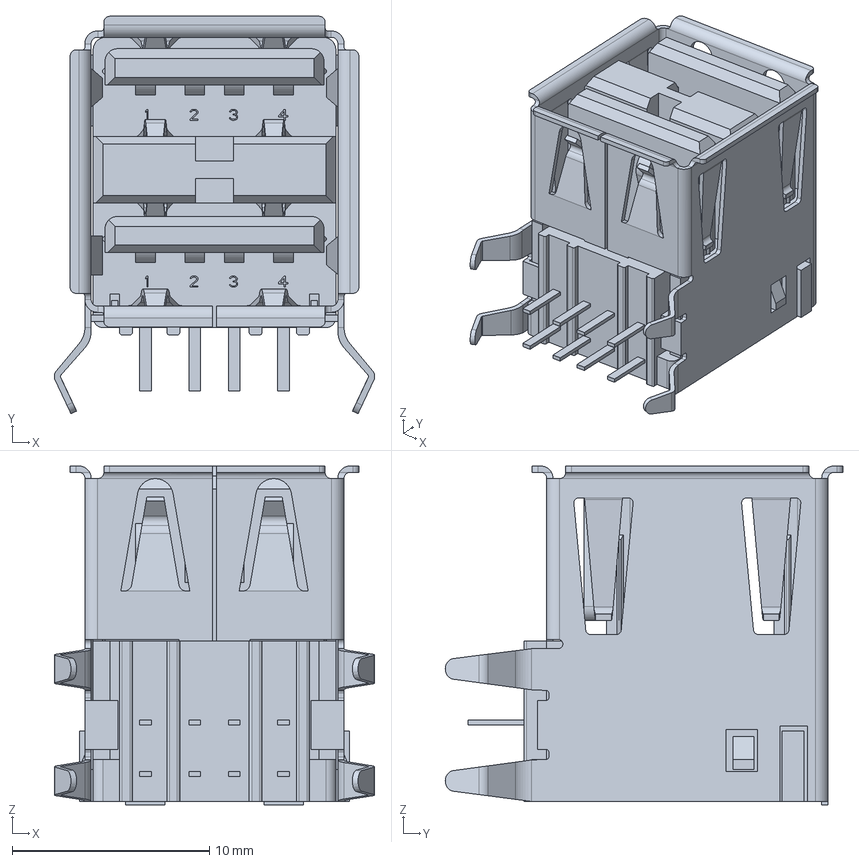
[picture p65: CAD file, 2025-03-13]
3dmodels/Connectors/USB2.0-A-双层直插.stp
16.2 x 20.1 x 17.2 mm
