emoestudio/EmoeKiLib/3dmodels/Connectors/SM12B-SHLS-TF.STEP

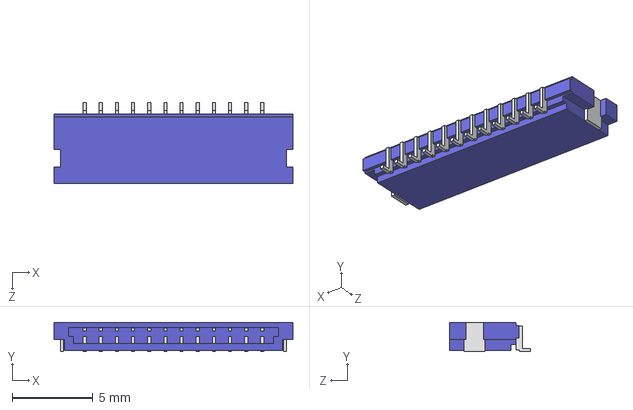
[picture p66: CAD file, 2025-03-13]
3dmodels/Connectors/SM12B-SHLS-TF.STEP
14.8 x 1.80 x 5.00 mm
