emoestudio/EmoeKiLib/3dmodels/Connectors/BM12B-SRSS-TB_LF__SN_.stp

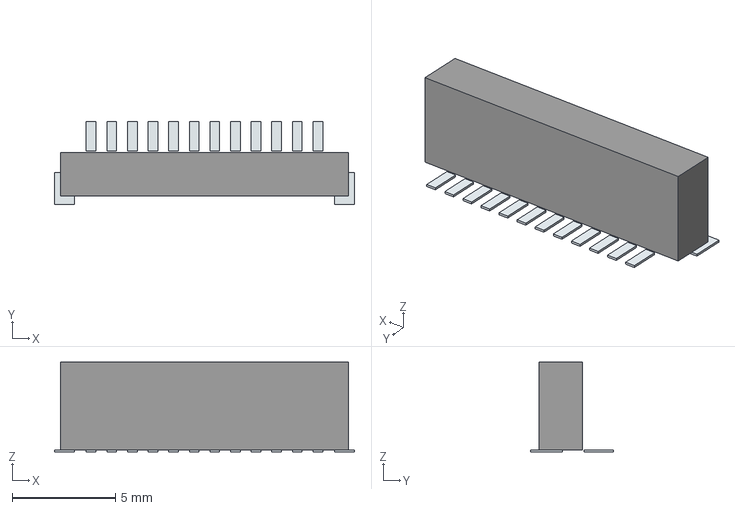
[picture p67: CAD file, 2025-03-13]
3dmodels/Connectors/BM12B-SRSS-TB_LF__SN_.stp
14.6 x 4.02 x 4.35 mm
Pins
