emoestudio/EmoeKiLib/3dmodels/Connectors/User Library-620-SMA-02-112-TGG SMA Female for PCB edge Mount.STEP

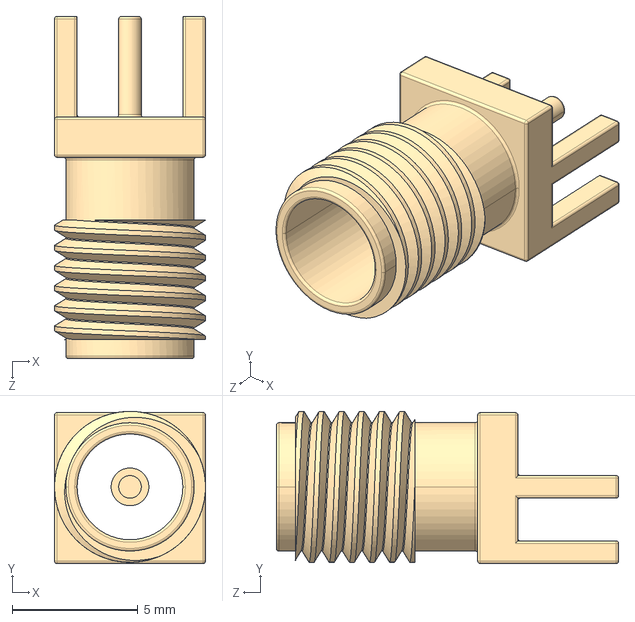
[picture p68: CAD file, 2024-11-20]
3dmodels/Connectors/User Library-620-SMA-02-112-TGG SMA Female for PCB edge Mount.STEP
6.00 x 6.05 x 13.6 mm
