emoestudio/EmoeKiLib/3dmodels/Connectors/PJ-327A0-SMT.stp

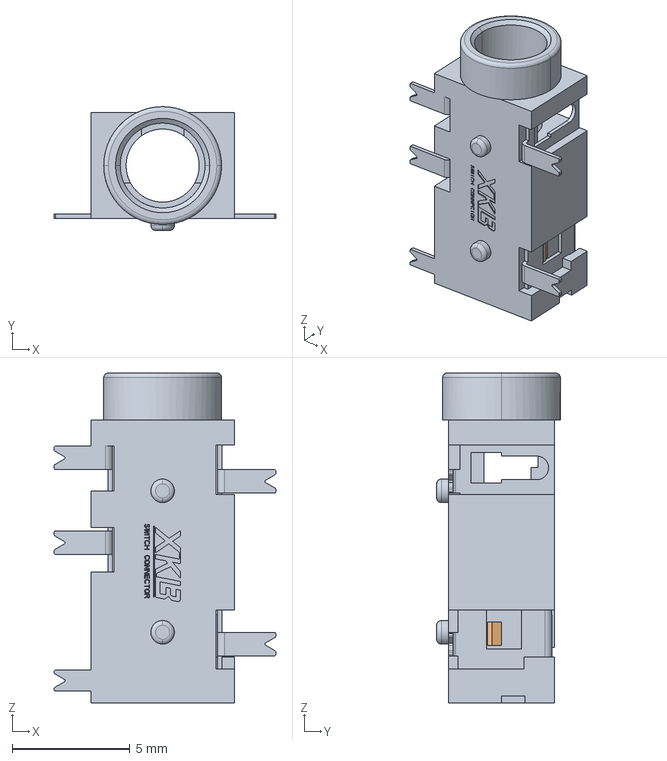
[picture p69: CAD file, 2024-08-25]
3dmodels/Connectors/PJ-327A0-SMT.stp
9.40 x 5.25 x 14.0 mm
