emoestudio/EmoeKiLib/3dmodels/Connectors/KF2EDGR-2.54-03P.STEP

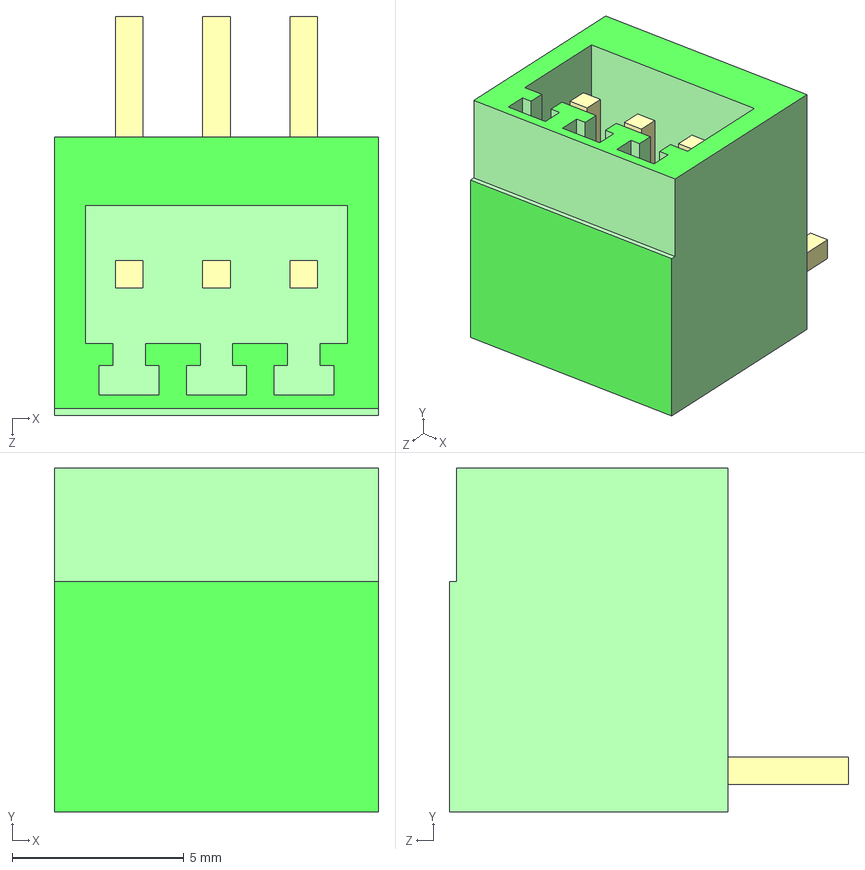
[picture p70: CAD file, 2024-08-11]
3dmodels/Connectors/KF2EDGR-2.54-03P.STEP
9.42 x 10.0 x 11.6 mm
