emoestudio/EmoeKiLib/3dmodels/Connectors/KF2EDGR-2.54-09P.STEP

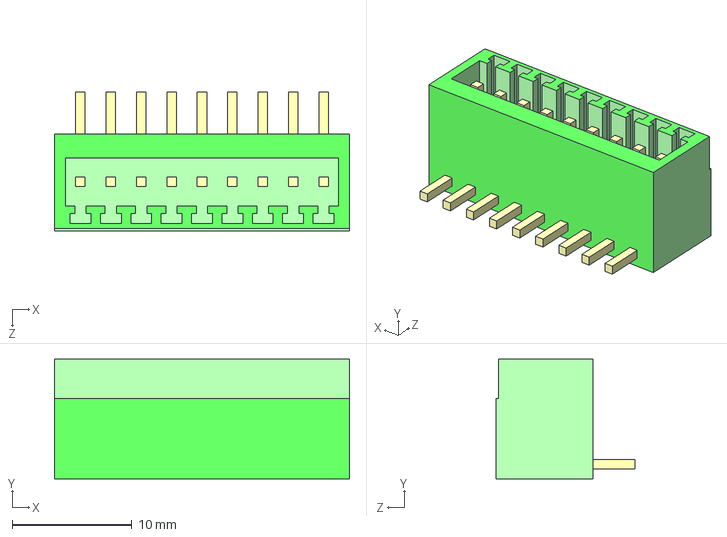
[picture p71: CAD file, 2024-08-11]
3dmodels/Connectors/KF2EDGR-2.54-09P.STEP
24.7 x 10.0 x 11.6 mm
