emoestudio/EmoeKiLib/3dmodels/Connectors/KF2EDGR-2.54-02P.STEP

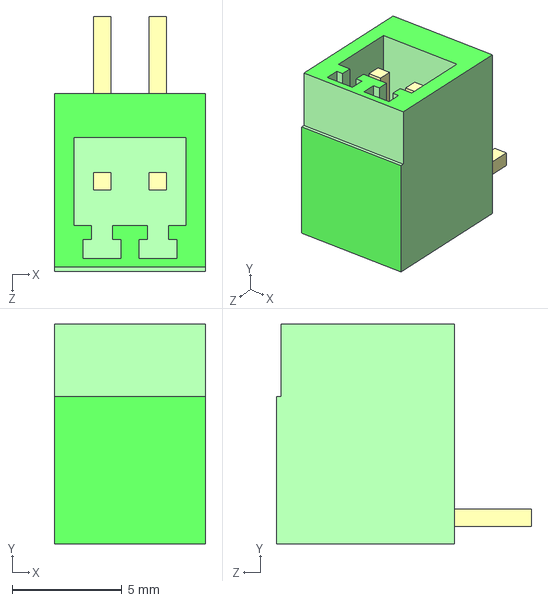
[picture p72: CAD file, 2024-08-11]
3dmodels/Connectors/KF2EDGR-2.54-02P.STEP
6.88 x 10.0 x 11.6 mm
