emoestudio/EmoeKiLib/3dmodels/Connectors/KF2EDGR-2.54-04P.STEP

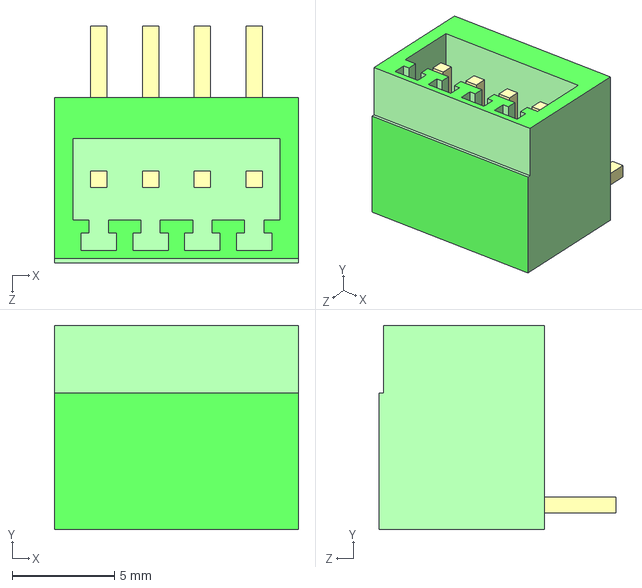
[picture p73: CAD file, 2024-08-11]
3dmodels/Connectors/KF2EDGR-2.54-04P.STEP
12.0 x 10.0 x 11.6 mm
