emoestudio/EmoeKiLib/3dmodels/Connectors/KF2EDGR-2.54-11P.STEP

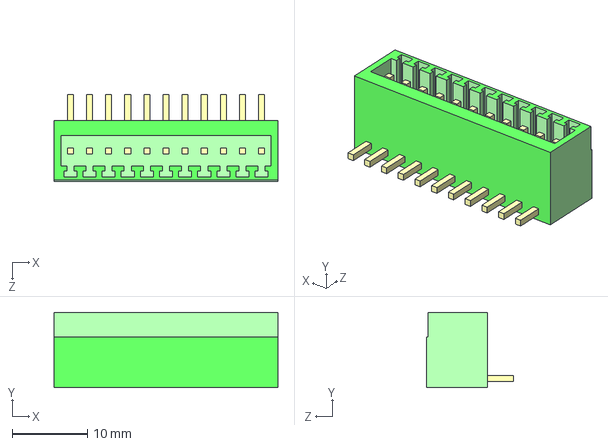
[picture p74: CAD file, 2024-08-11]
3dmodels/Connectors/KF2EDGR-2.54-11P.STEP
29.7 x 10.0 x 11.6 mm
