emoestudio/EmoeKiLib/3dmodels/Connectors/KF2EDGR-2.54-10P.STEP

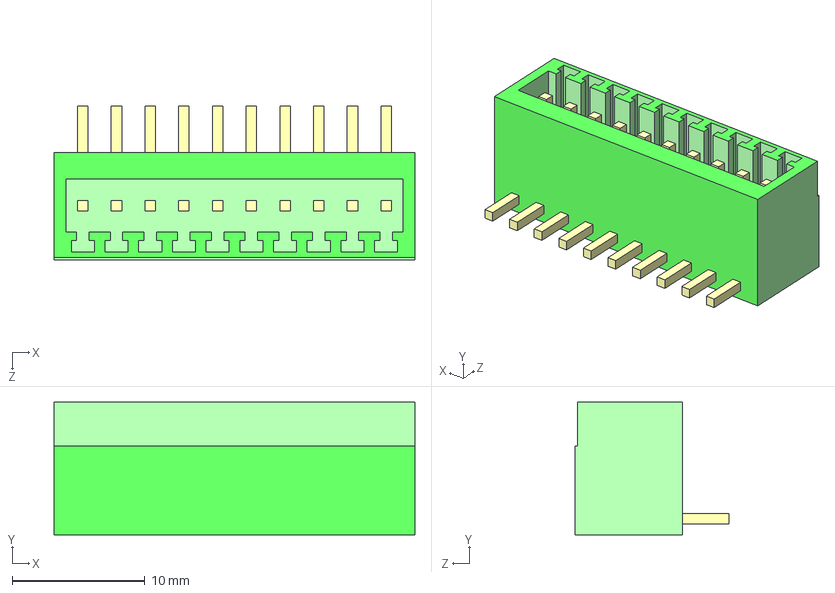
[picture p75: CAD file, 2024-08-11]
3dmodels/Connectors/KF2EDGR-2.54-10P.STEP
27.2 x 10.0 x 11.6 mm
