emoestudio/EmoeKiLib/3dmodels/Connectors/KF2EDGR-2.54-05P.STEP

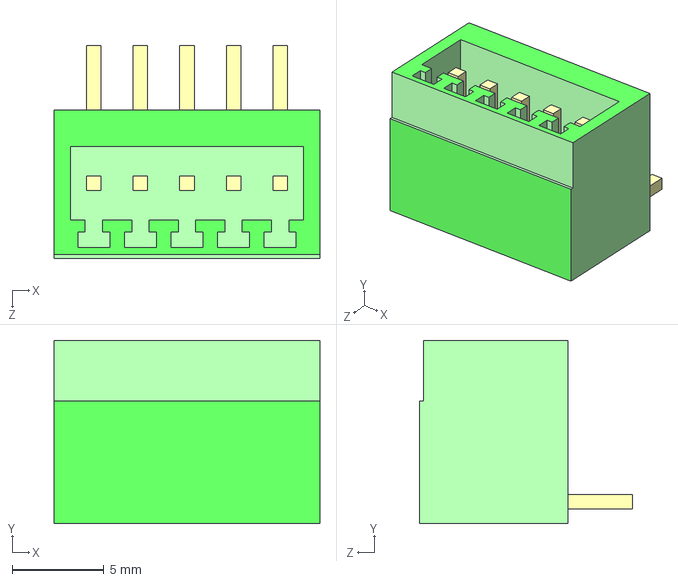
[picture p76: CAD file, 2024-08-11]
3dmodels/Connectors/KF2EDGR-2.54-05P.STEP
14.5 x 10.0 x 11.6 mm
