emoestudio/EmoeKiLib/3dmodels/Connectors/KF2EDGR-2.54-06P.STEP

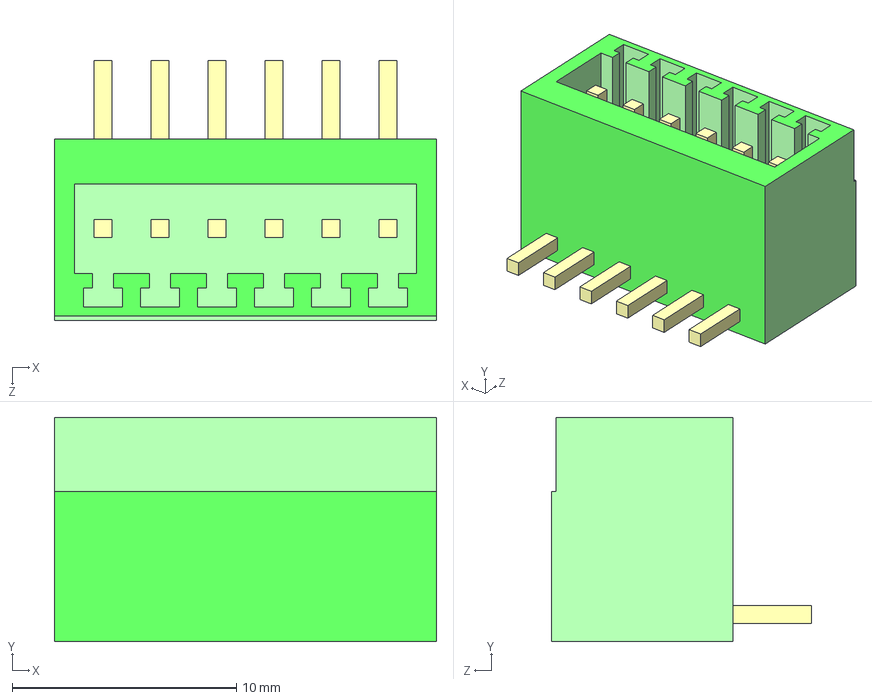
[picture p77: CAD file, 2024-08-11]
3dmodels/Connectors/KF2EDGR-2.54-06P.STEP
17.0 x 10.0 x 11.6 mm
