emoestudio/EmoeKiLib/3dmodels/Connectors/KF2EDGR-2.54-07P.STEP

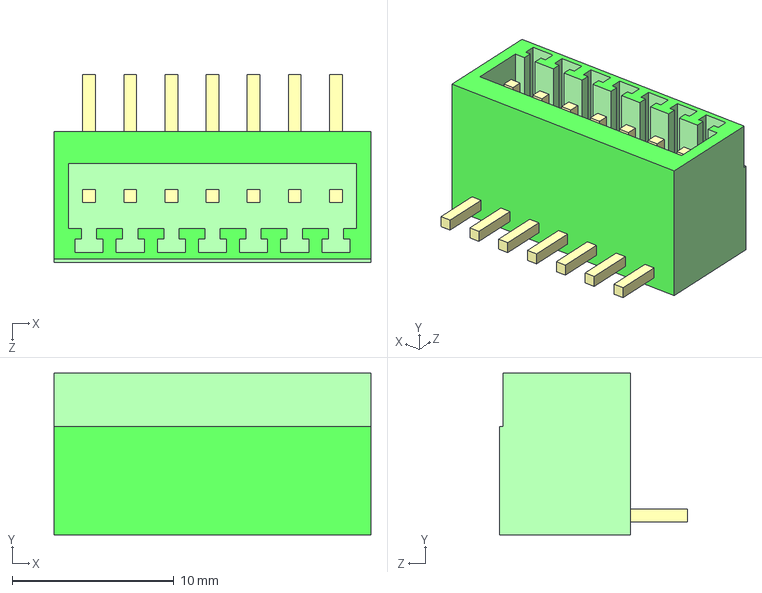
[picture p78: CAD file, 2024-08-11]
3dmodels/Connectors/KF2EDGR-2.54-07P.STEP
19.6 x 10.0 x 11.6 mm
