emoestudio/EmoeKiLib/3dmodels/Connectors/KF2EDGR-2.54-12P.STEP

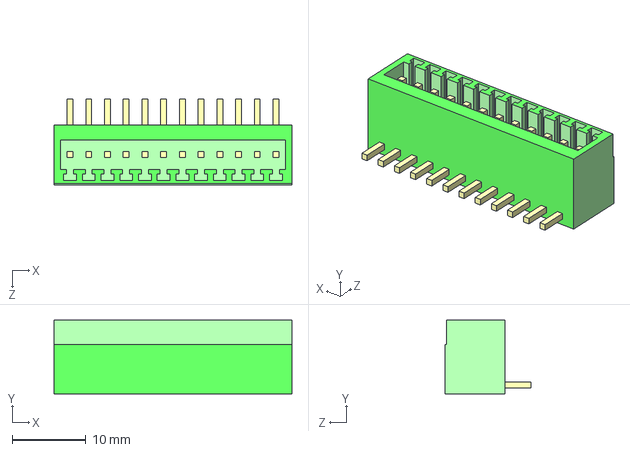
[picture p79: CAD file, 2024-08-11]
3dmodels/Connectors/KF2EDGR-2.54-12P.STEP
32.3 x 10.0 x 11.6 mm
