emoestudio/EmoeKiLib/3dmodels/Connectors/SMA - 50 Ohm Connectors 142-0701-801.STEP

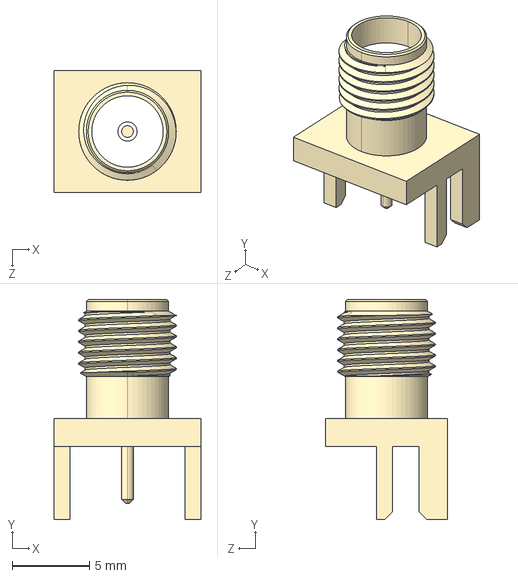
[picture p80: CAD file, 2024-07-07]
3dmodels/Connectors/SMA - 50 Ohm Connectors 142-0701-801.STEP
9.52 x 14.3 x 7.92 mm
