emoestudio/EmoeKiLib/3dmodels/Connectors/1.25mm_5P.STEP

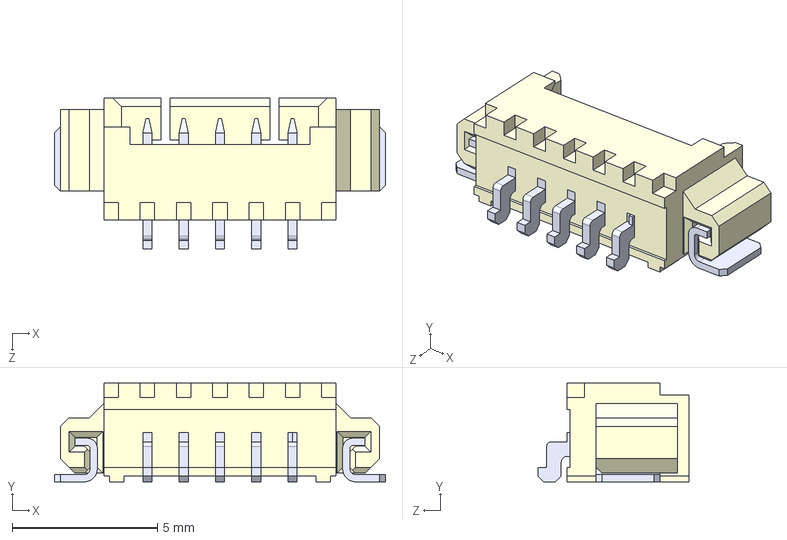
[picture p81: CAD file, 2024-07-07]
3dmodels/Connectors/1.25mm_5P.STEP
11.4 x 3.40 x 5.20 mm
