emoestudio/EmoeKiLib/3dmodels/Connectors/1.25-4PWTDK.stp

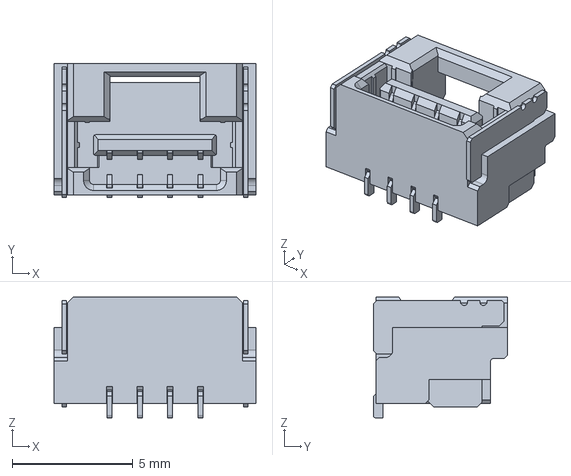
[picture p82: CAD file, 2024-07-07]
3dmodels/Connectors/1.25-4PWTDK.stp
8.35 x 5.55 x 5.00 mm
