emoestudio/EmoeKiLib/3dmodels/Connectors/KF2EDGR-2.54-08P.STEP

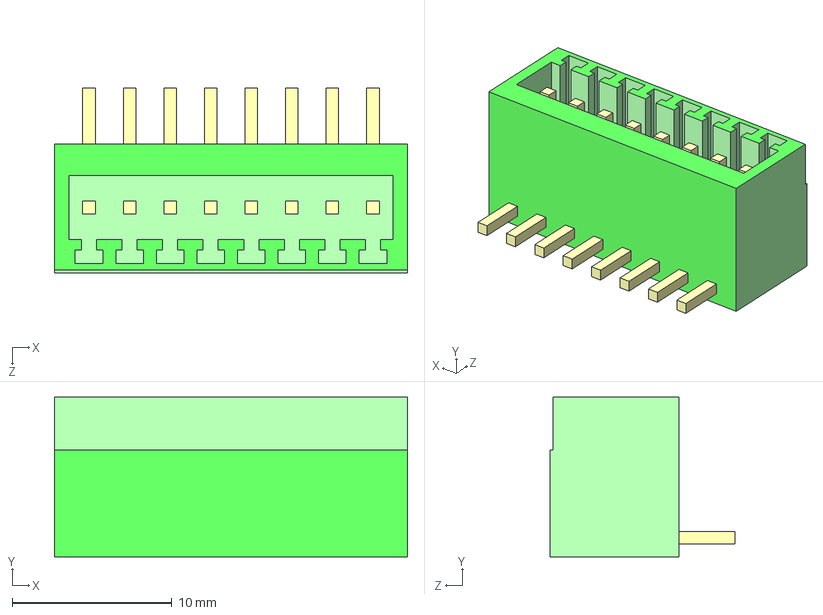
[picture p83: CAD file, 2024-03-26]
3dmodels/Connectors/KF2EDGR-2.54-08P.STEP
22.1 x 10.0 x 11.6 mm
