emoestudio/EmoeKiLib/3dmodels/Connectors/Amphenol-SMA-901-143-6RFX.STEP

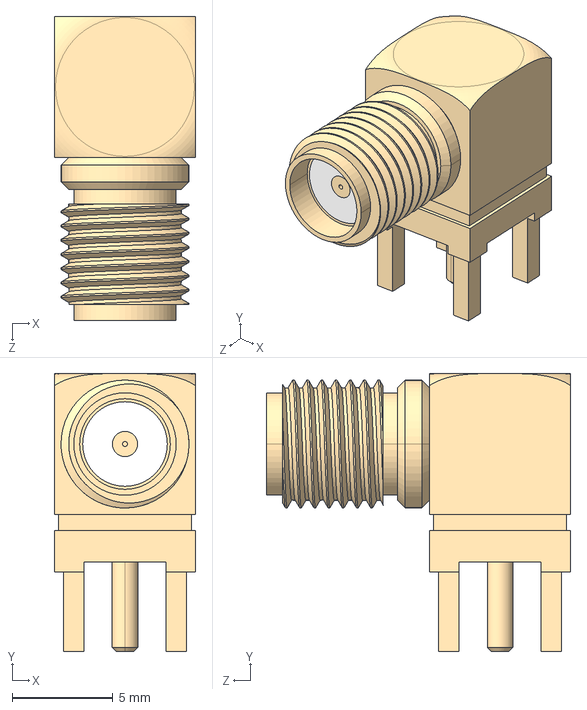
[picture p84: CAD file, 2023-12-12]
3dmodels/Connectors/Amphenol-SMA-901-143-6RFX.STEP
7.00 x 13.8 x 15.1 mm
