emoestudio/EmoeKiLib/3dmodels/Connectors/SGDBF-08-012P-H40.stp

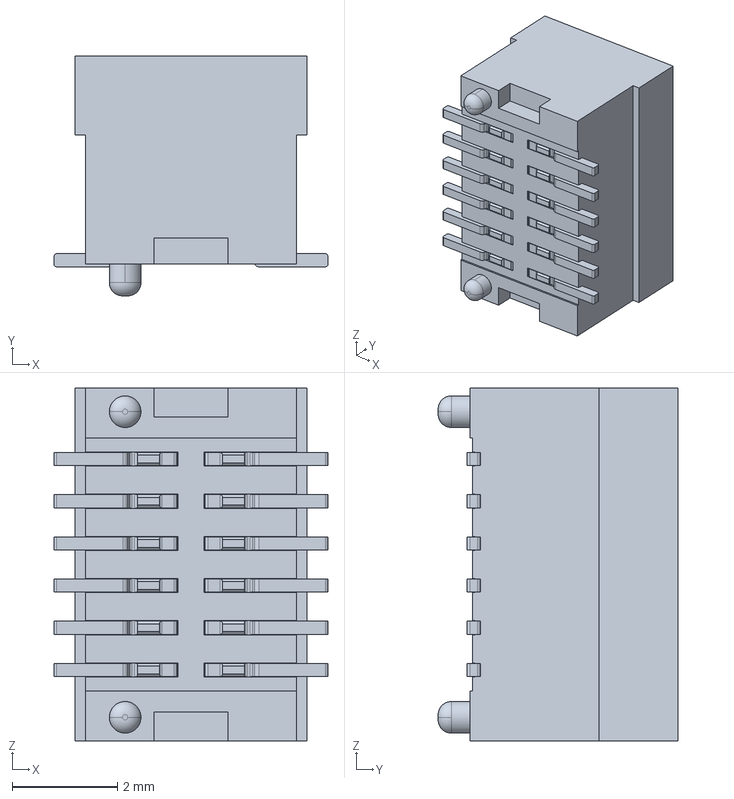
[picture p85: CAD file, 2023-12-09]
3dmodels/Connectors/SGDBF-08-012P-H40.stp
5.20 x 4.55 x 6.70 mm
