emoestudio/EmoeKiLib/3dmodels/Connectors/SGDBF-08-008P-H40.stp

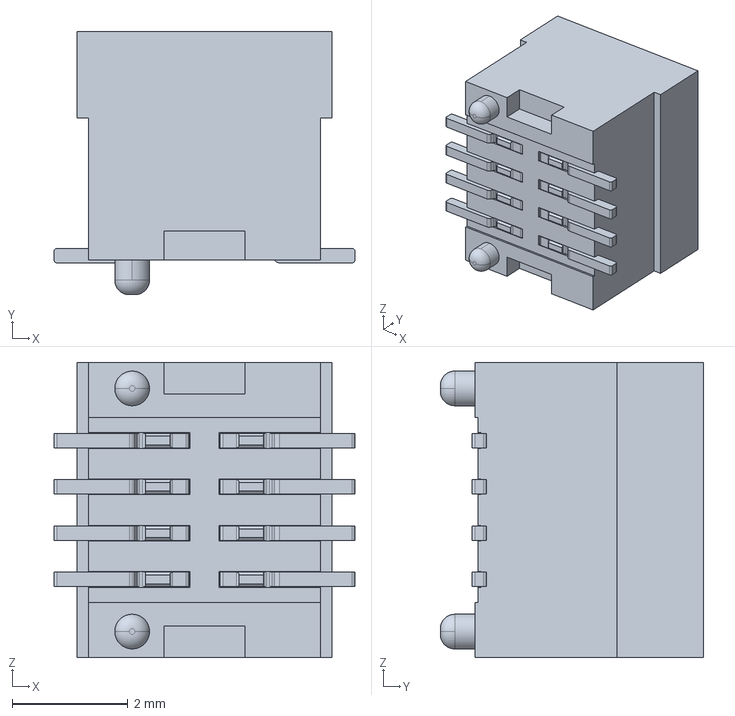
[picture p86: CAD file, 2023-12-09]
3dmodels/Connectors/SGDBF-08-008P-H40.stp
5.20 x 4.55 x 5.10 mm
