emoestudio/EmoeKiLib/3dmodels/Connectors/SGDBM-08-012P-H10.stp

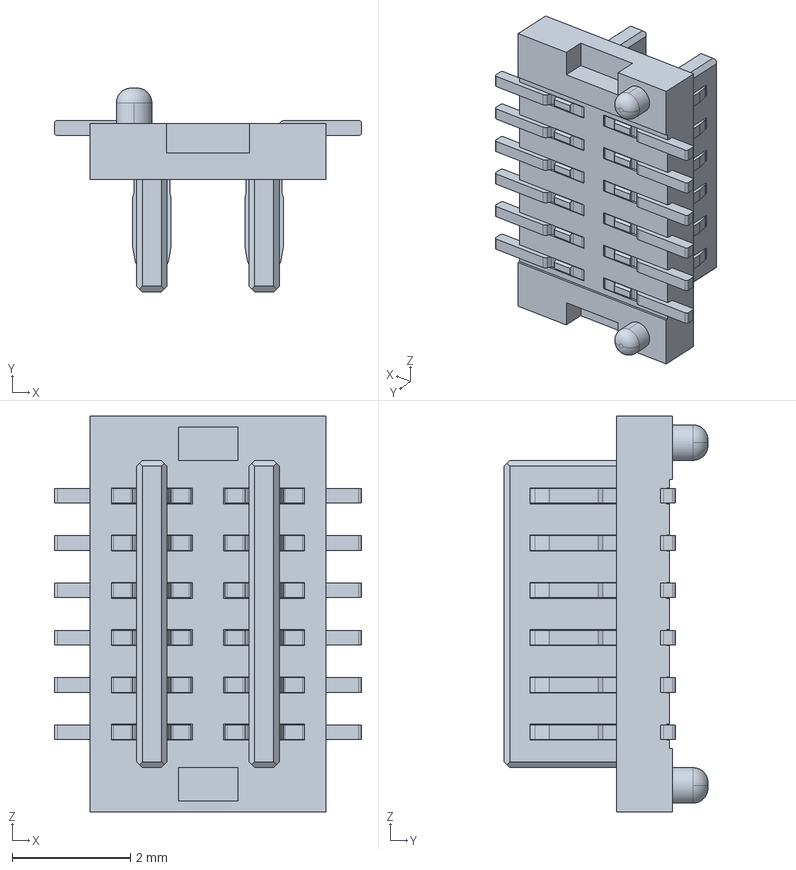
[picture p87: CAD file, 2023-12-09]
3dmodels/Connectors/SGDBM-08-012P-H10.stp
5.20 x 3.45 x 6.70 mm
