emoestudio/EmoeKiLib/3dmodels/Connectors/SGDBM-08-008P-H10.stp

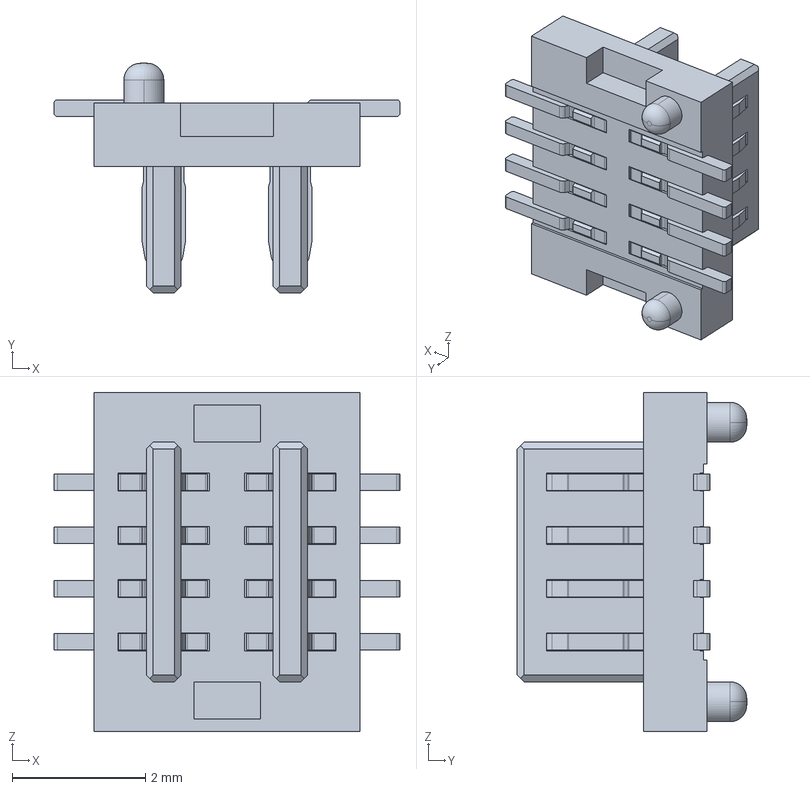
[picture p88: CAD file, 2023-12-09]
3dmodels/Connectors/SGDBM-08-008P-H10.stp
5.20 x 3.45 x 5.10 mm
