emoestudio/EmoeKiLib/(list of files, cad)

Other CAD files:
3dmodels/Switch_Encoders/SA-0-102-C04-0004-WP.step
3dmodels/Package_DFN_QFN/TPS566238.stp
3dmodels/Package_DFN_QFN/TPS63070RNMT.step
3dmodels/Transformers/760390015--3DModel-STEP-56544.STEP
