emoestudio/EmoeKiLib/(commit log)

2023-12-09 2023-12-9 update
    [AD4632-24BBCZ.stp, LTM8054EY#PBF.stp, NFM21PC225B0J3D.step, SGDBF-08-008P-H40.stp, SGDBF-08-012P-H40.stp, SGDBM-08-008P-H10.stp, SGDBM-08-012P-H10.stp]
2023-12-10 daily update
    [MTS-1xx-C3-blue.step, SS-12D11.STEP]
2023-12-12 update 2023-12-12
    [Amphenol-SMA-901-143-6RFX.STEP]
2024-01-21 update 2024-1-21
    [UMSB30M.stp]
2024-03-26 Floydfish commit 20240326
    [KF2EDGR-2.54-08P.STEP]
2024-08-11 update 20240811
    [KF2EDGR-2.54-02P.STEP, KF2EDGR-2.54-03P.STEP, KF2EDGR-2.54-04P.STEP, KF2EDGR-2.54-05P.STEP, KF2EDGR-2.54-06P.STEP, KF2EDGR-2.54-07P.STEP, KF2EDGR-2.54-09P.STEP, KF2EDGR-2.54-10P.STEP]
2024-08-25 update 20240826
    [PJ-327A0-SMT.stp, TPS63070RNMT.step]
2024-11-20 update 20241120
    [User Library-620-SMA-02-112-TGG SMA Female for PCB edge Mount.STEP]
2024-12-31 update 20241231
    [1206_Common_Mode_Choke.STEP, 3225_4P_Crystal.STEP]
2025-03-13 update 2025-0313
    [BM12B-SRSS-TB.STEP, BM12B-SRSS-TB_LF__SN_.stp, SM12B-SHLS-TF.STEP, USB2.0-A-双层直插.stp]
2025-03-30 update 2025-0330
    [SRBM120700.stp, Tactal Switch - SMD (12mmx12mmx7.5mm).stp, VHP203-MetalFoil.step]
2025-04-11 add powermodule conn
2025-04-12 add adr1399khz footprint
2025-05-03 update 2025-0504
    [3mm双孔灯座_上翠绿下红.step, ADR1001AEZ.stp, Amphernol_SMA_Verticle_901-144-3.stp]
2025-05-03 change sma hole to 1.3mm
2025-05-23 Update 2025-0523
    [ADR1399KEZ.stp]
2025-06-23 update 2025-0623
    [TEMD5080X01.stp]
2025-07-08 update 2025-0708
    [VPS8504_BipolarOutput_±5V.step]
2025-07-30 update 2025-0730
    [VPS8504_BipolarOutput_±5V.step]
2025-10-14 update 2025-1014
    [FCR7350-BananaJack.stp]
2025-12-01 update 20251201
    [BNC-KWE-90 degrees.STEP, MTS-1xx-A4-blue.step]
2025-12-01 update merge 20251201
    [USB-B-S-F-W-TH.stp]
2026-02-11 update 20260211
    [BNC-KWE-90degrees-15mm.STEP, PE4820-I.step, PER-08H.step, PH2.0-2PWB.step, SMA-KWE-20mm.step, TYPE-C 6P CB1.6.step, USB Type-B Stand.step, VPT85BB-01A.stp]
2026-07-21 Update 20260721
    [590--3DModel-STEP-630548.STEP, 6x6mm_17mm_Button_THT.stp, 760390015--3DModel-STEP-56544.STEP, FPC-SMD_20P-P0.50_XUNPU_FPC-05F-20PH20.step, HC-1.25-3PWT.step, JST - VH - Thru (V) - 10Pin - 3.96mm.stp, JST - VH - Thru (V) - 11Pin - 3.96mm.stp, JST - VH - Thru (V) - 12Pin - 3.96mm.stp]
