emoestudio/EmoeKiLib/(notices)

Notices in the files:
3dmodels/Connectors/USB-B-S-F-W-TH.stp:
author */ ('License CC BY-ND 4.0'),
